CameronMccutcheon02/ECE477/Personals/Joey/newCalibrationPics/WIN_20231114_16_17_02_Pro.jpg

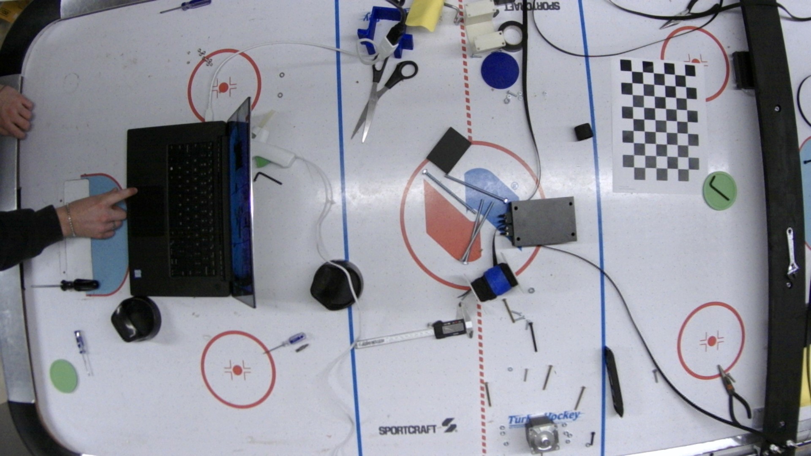
Personals/Joey/newCalibrationPics/WIN_20231114_16_17_02_Pro.jpg
