CameronMccutcheon02/ECE477/README.md

# ECE477
Final Project Repository for ECE477 building an air hockey robot. 
Link to website repo: https://github.com/CameronMccutcheon02/ECE477Website
