CameronMccutcheon02/ECE477/Hardware/README.md

# ECE477
Hardware section of the ECE477 repository. This directory to contain all of the system diagrams, PCB files, etc relating to hardware of the robot
