CameronMccutcheon02/ECE477/Software/README.md

# ECE477
This folder to contain all software (both micro and powerPC) software written for the air hockey bot
