CameronMccutcheon02/ECE477/Hardware/Notes.txt

Parts Needed
STM32f091RCT6
JTAG 10 pin flat ribbon connector
