CameronMccutcheon02/ECE477/Personals/Abby/Notes.txt

-------------- WEEK 14 PROGRESS ------------- 
Notes:
- troubleshooting motors
    - it looks like the Nema23 can handle 3A? look into upping the current by driver switch settings
    - Nema23 seem to often be powered off of 48V 
    - test with different steps/rev settings ?

- hours
    - fri: 2 (starting integration)
    - sat: 8 w joey this sucked (troubleshooting camera w motors / motor problem)
    - sun: 2 (worked on keys code + troubleshooting + research into motors)
    - mon

To-do:
- troubleshoo
