CameronMccutcheon02/ECE477/Hardware/477 Electrical Overview.drawio.png

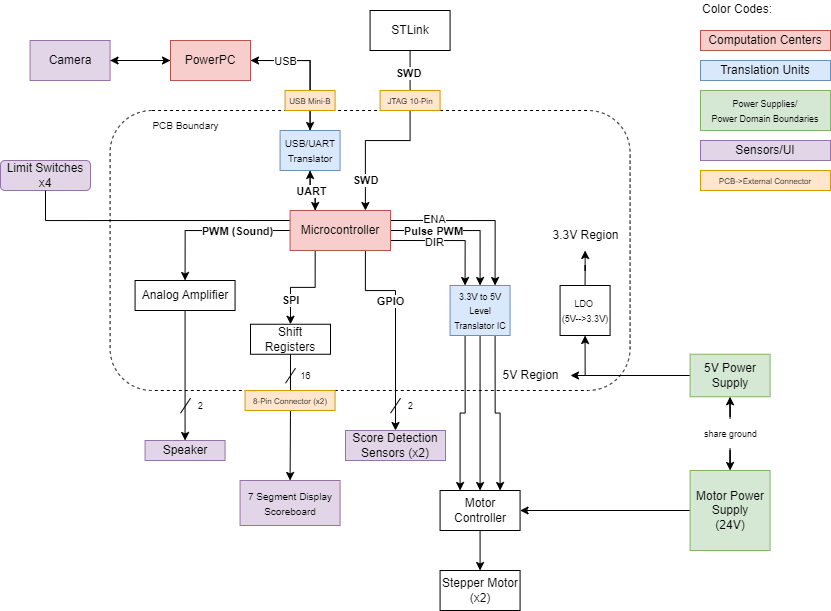
Hardware/477 Electrical Overview.drawio.png
