CameronMccutcheon02/ECE477/Personals/Joey/falseMallet.jpg

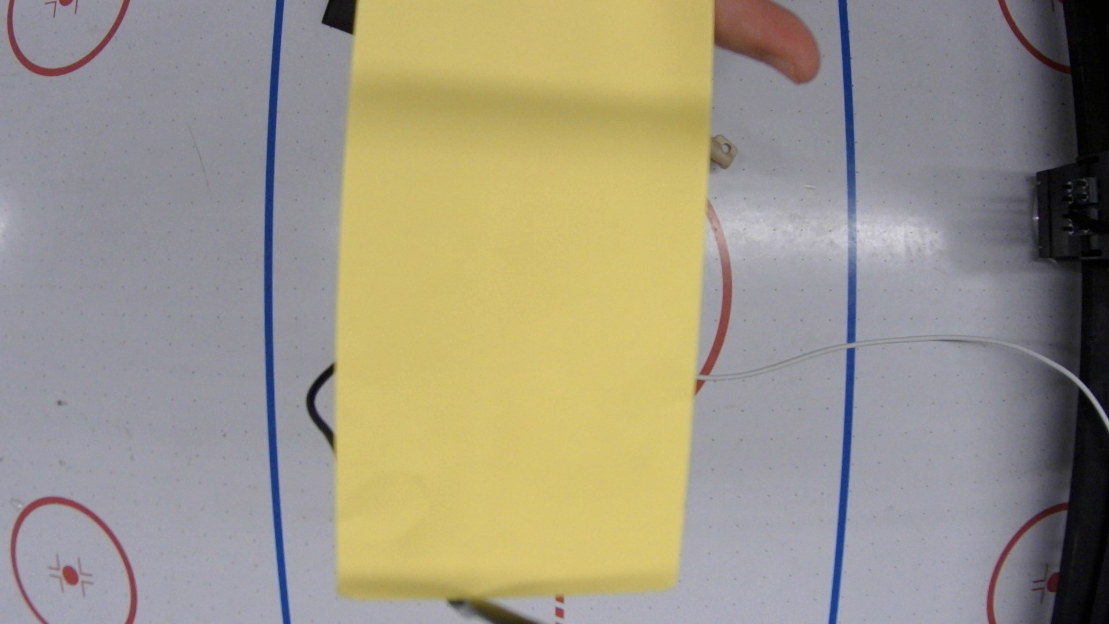
Personals/Joey/falseMallet.jpg
