CameronMccutcheon02/ECE477/Personals/Joey/goldmalletPic.jpg

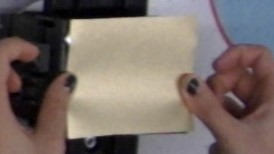
Personals/Joey/goldmalletPic.jpg
