CameronMccutcheon02/ECE477/Personals/Joey/malletPic.jpg

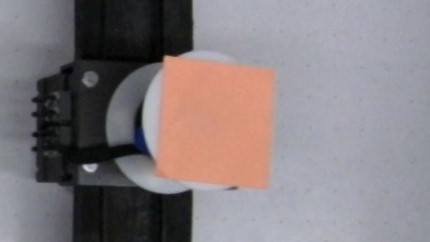
Personals/Joey/malletPic.jpg
