CameronMccutcheon02/ECE477/Personals/Joey/pinkmalletPic.jpg

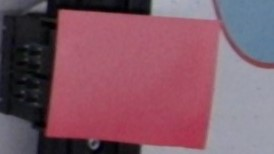
Personals/Joey/pinkmalletPic.jpg
