CameronMccutcheon02/ECE477/Personals/Joey/puckPic.jpg

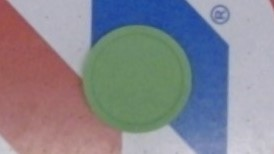
Personals/Joey/puckPic.jpg
