CameronMccutcheon02/ECE477/Personals/Joey/purplemalletPic.jpg

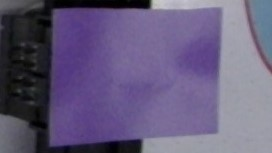
Personals/Joey/purplemalletPic.jpg
