CameronMccutcheon02/ECE477/Personals/Joey/yellowmalletPic.jpg

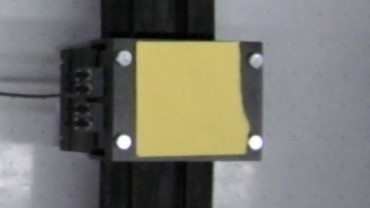
Personals/Joey/yellowmalletPic.jpg
