CameronMccutcheon02/ECE477/Mechanics/Senior Design Purchase Request (Amazon).xlsx

College of Engineering Senior Design Purchase Request Form |  |  | Department Name: | Today's Date: | 2023-09-29
 |  |  | ECE | Need-By Date: | ASAP
Vendor: | Amazon |  | Team Name / Project: | Your Name: | Abby Haluska
Website: | Amazon.com |  | 16 / Air Hockey Robot | Building.: | BHEE
Phone Number: |  |  |  | Room Number: | 7
Vendor Contact: |  |  | Account Number: | Phone Number: | 219-801-8580
Contact Email: |  |  | 7600000796 | Email Address: | ahaluska@purdue.edu
ITEM NAME / PART NUMBER |  | DESCRIPTION & LINK |  |  | QUANTITY | UNIT COST | TOTAL COST
VEVOR Linear Rail, 2 PCS SBR16-1000 / B0BLSD9WY3 |  | VEVOR Linear Rail / https://www.amazon.com/VEVOR-SBR12-1000mm-Carriage-Automated-Equipments/dp/B0BLSD9WY3 |  |  | 1.00 | $45.99 | $45.99
GT2 Open Timing Belt for 3D Printer 5M, 10MM width / B08SQ32RSR |  | Open Timing Belt / https://www.amazon.com/Timing-Printer-Meters-Fiberglass-Reinforced/dp/B08SQ32RSR |  |  | 1.00 | $16.89 | $16.89
 |  |  |  |  |  |  | $0.00
 |  |  |  |  |  |  | $0.00
 |  |  |  |  |  |  | $0.00
 |  |  |  |  |  | $0.00 | $0.00
 |  |  |  |  |  | $0.00 | $0.00
 |  |  |  |  |  | $0.00 | $0.00
 |  |  |  |  |  | $0.00 | $0.00
 |  |  |  |  |  | $0.00 | $0.00
 |  |  |  |  |  | $0.00 | $0.00
 |  |  |  |  |  | $0.00 | $0.00
 |  |  |  |  |  | $0.00 | $0.00
 |  |  |  |  |  | $0.00 | $0.00
 |  |  |  |  |  | $0.00 | $0.00
 |  |  |  |  |  | $0.00 | $0.00
 |  |  |  |  |  | $0.00 | $0.00
 |  |  |  |  |  | $0.00 | $0.00
 |  |  |  |  |  | $0.00 | $0.00
 |  |  |  |  |  | $0.00 | $0.00
 |  |  |  |  |  | $0.00 | $0.00
Shipping / Handling |  |  |  |  |  | $0.00 | $0.00
Requisition Total |  |  |  |  |  |  | $62.88
*** ALL BLUE CELLS are Mandatory *** Do Not Alter Formulas ***
