CameronMccutcheon02/ECE477/Mechanics/Senior Design Purchase Request (Adafruit).xlsx

College of Engineering Senior Design Purchase Request Form |  |  | Department Name: | Today's Date: | 2023-09-21
 |  |  | ECE | Need-By Date: | ASAP
Vendor: | Adafruit |  | Team Name / Project: | Your Name: | Abby Haluska
Website: | www.adafruit.com |  | 16 / Air Hockey Robot | Building: | EE
Phone Number: | 646-248-7822 |  |  | Room Number: | 7
Vendor Contact: | - |  | Account Number: | Phone Number: | 219-801-8580
Contact Email: | support@adafruit.com |  | 7600000796 | Email Address: | ahaluska@purdue.edu
ITEM NAME / PART NUMBER |  | DESCRIPTION & LINK |  |  | QUANTITY | UNIT COST | TOTAL COST
IR Break Beam Sensor with Premium Wire Header Ends - 5mm LEDs / 2168 |  | Infrared (IR) break-beam sensors / https://www.adafruit.com/product/2168 |  |  | 2.00 | $5.95 | $11.90
 |  |  |  |  |  | $0.00 | $0.00
 |  |  |  |  |  | $0.00 | $0.00
 |  |  |  |  |  | $0.00 | $0.00
 |  |  |  |  |  | $0.00 | $0.00
 |  |  |  |  |  | $0.00 | $0.00
 |  |  |  |  |  | $0.00 | $0.00
 |  |  |  |  |  | $0.00 | $0.00
 |  |  |  |  |  | $0.00 | $0.00
 |  |  |  |  |  | $0.00 | $0.00
 |  |  |  |  |  | $0.00 | $0.00
 |  |  |  |  |  | $0.00 | $0.00
 |  |  |  |  |  | $0.00 | $0.00
 |  |  |  |  |  | $0.00 | $0.00
 |  |  |  |  |  | $0.00 | $0.00
 |  |  |  |  |  | $0.00 | $0.00
 |  |  |  |  |  | $0.00 | $0.00
 |  |  |  |  |  | $0.00 | $0.00
 |  |  |  |  |  | $0.00 | $0.00
 |  |  |  |  |  | $0.00 | $0.00
 |  |  |  |  |  | $0.00 | $0.00
Shipping / Handling |  |  |  |  |  | $0.00 | $0.00
Requisition Total |  |  |  |  |  |  | $11.90
*** ALL BLUE CELLS are Mandatory *** Do Not Alter Formulas ***
