CameronMccutcheon02/ECE477/Mechanics/Senior Design Purchase Request (Mouser).xlsx

College of Engineering Senior Design Purchase Request Form |  |  | Department Name: | Today's Date:
 |  |  | ECE | Need-By Date:
Vendor: | Mouser |  | Team Name / Project: | Your Name: | Abby Haluska
Website: | www.mouser.com |  | 16 / Air Hockey Robot | Building: | EE
Phone Number: | 1-800-346-6873 |  |  | Room Number: | 7
Vendor Contact: | - |  | Account Number: | Phone Number: | 219-801-8580
Contact Email: | sales@mouser.com |  | 7600000796 | Email Address: | ahaluska@purdue.edu
ITEM NAME / PART NUMBER |  | DESCRIPTION & LINK |  |  | QUANTITY | UNIT COST | TOTAL COST
STM32F091RCT6 / 511 |  | ARM Microcontrollers - MCU Mainstream Arm Cortex-M0 / https://www.mouser.com/ProductDetail/STMicroelectronics/STM32F091RCT6?qs=ClYTdQWm4hDCc82GnPpqOQ%3D%3D |  |  | 3.00 | $5.36 | $16.08
 |  |  |  |  |  | $0.00 | $0.00
 |  |  |  |  |  | $0.00 | $0.00
 |  |  |  |  |  | $0.00 | $0.00
 |  |  |  |  |  | $0.00 | $0.00
 |  |  |  |  |  | $0.00 | $0.00
 |  |  |  |  |  | $0.00 | $0.00
 |  |  |  |  |  | $0.00 | $0.00
 |  |  |  |  |  | $0.00 | $0.00
 |  |  |  |  |  | $0.00 | $0.00
 |  |  |  |  |  | $0.00 | $0.00
 |  |  |  |  |  | $0.00 | $0.00
 |  |  |  |  |  | $0.00 | $0.00
 |  |  |  |  |  | $0.00 | $0.00
 |  |  |  |  |  | $0.00 | $0.00
 |  |  |  |  |  | $0.00 | $0.00
 |  |  |  |  |  | $0.00 | $0.00
 |  |  |  |  |  | $0.00 | $0.00
 |  |  |  |  |  | $0.00 | $0.00
 |  |  |  |  |  | $0.00 | $0.00
 |  |  |  |  |  | $0.00 | $0.00
Shipping / Handling |  |  |  |  |  | $0.00 | $0.00
Requisition Total |  |  |  |  |  |  | $16.08
*** ALL BLUE CELLS are Mandatory *** Do Not Alter Formulas ***
