CameronMccutcheon02/ECE477/Hardware/PCB/Useful Documentation/stm32f091-ref/stm32f091-ref/models/HTSW-130-22-T-S.FCStd

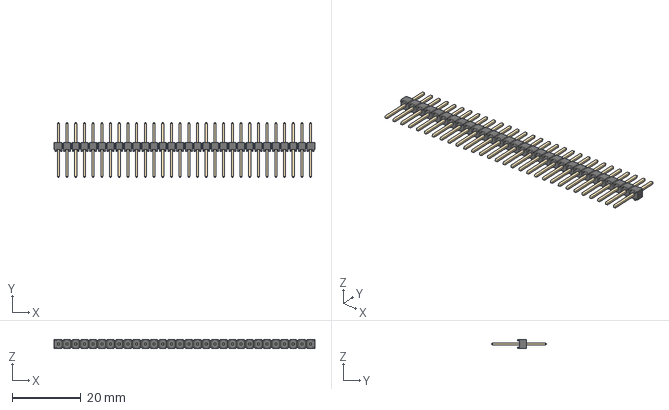
[picture p11: CAD file, 2023-09-29]
Hardware/PCB/Useful Documentation/stm32f091-ref/stm32f091-ref/models/HTSW-130-22-T-S.FCStd
76.2 x 16.0 x 2.49 mm
_HTSW-130-22-T-S_body
_T-1S6-15-HTSW-1--22-30-S
