CameronMccutcheon02/ECE477/Personals/Abby/cad/24v mount v2.stl

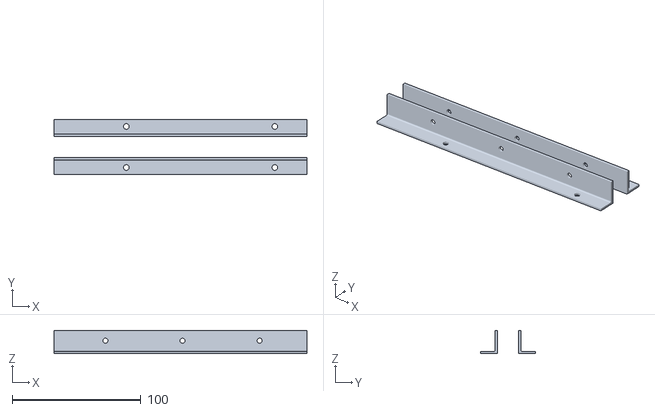
[picture p12: CAD file, 2023-11-19]
Personals/Abby/cad/24v mount v2.stl
196.9 x 42.9 x 18.0
