CameronMccutcheon02/ECE477/Hardware/PCB/Useful Documentation/stm32f091-ref/stm32f091-ref/models/ECX-.327-CDX-1293.step

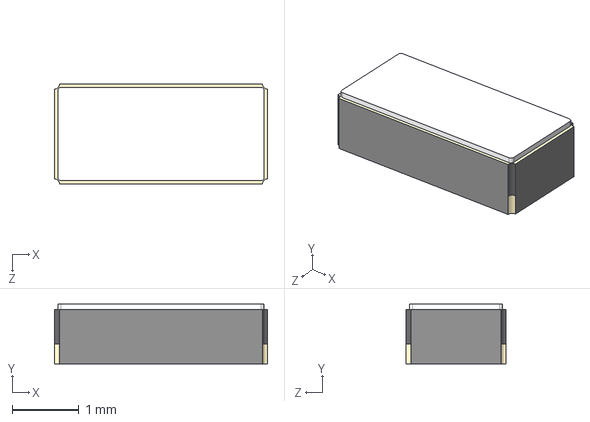
[picture p13: CAD file, 2023-09-29]
Hardware/PCB/Useful Documentation/stm32f091-ref/stm32f091-ref/models/ECX-.327-CDX-1293.step
3.20 x 0.9 x 1.50 mm
