CameronMccutcheon02/ECE477/Personals/Abby/cad/puck v1.stl

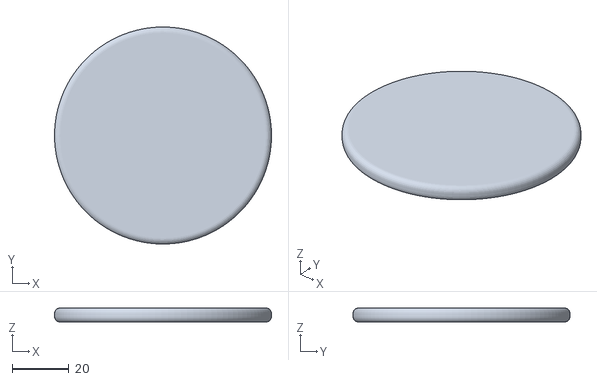
[picture p14: CAD file, 2023-10-17]
Personals/Abby/cad/puck v1.stl
76.2 x 76.2 x 5.00
