CameronMccutcheon02/ECE477/Personals/Abby/cad/cam v1 v0.stl

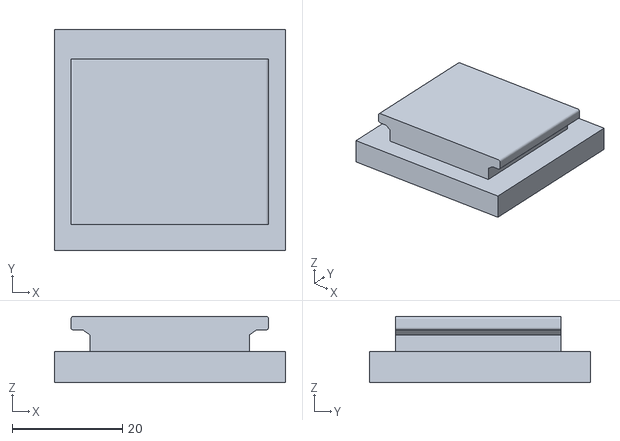
[picture p15: CAD file, 2023-10-17]
Personals/Abby/cad/cam v1 v0.stl
41.9 x 40.1 x 12.1
