CameronMccutcheon02/ECE477/Personals/Abby/cad/puck fun funnel.stl

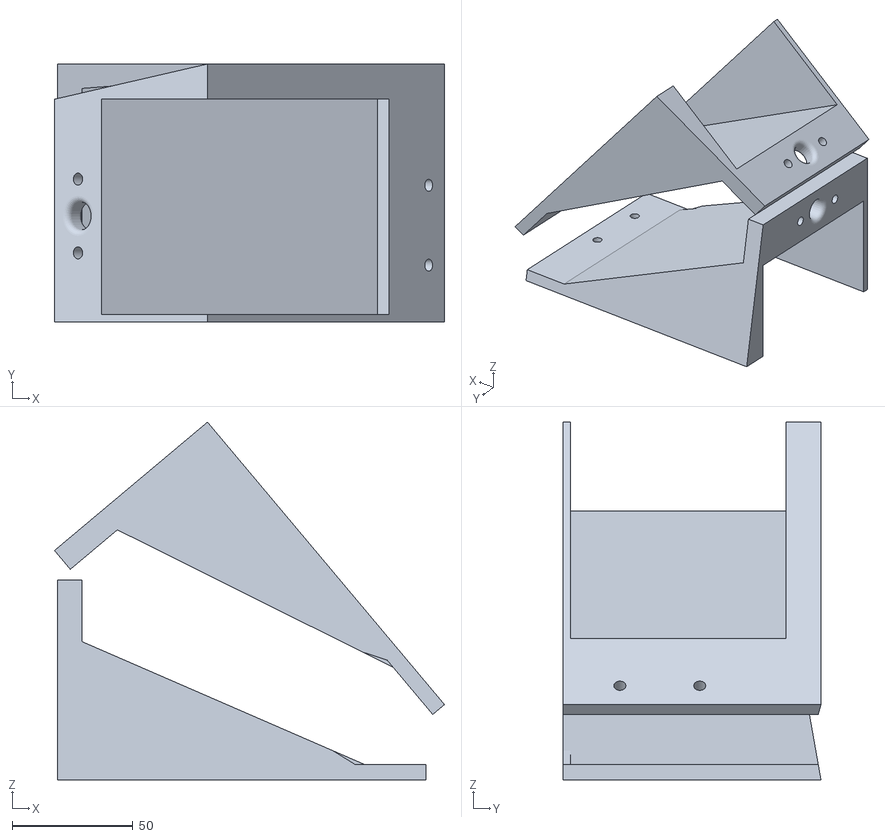
[picture p17: CAD file, 2023-09-20]
Personals/Abby/cad/puck fun funnel.stl
161.2 x 106.6 x 147.9
