CameronMccutcheon02/ECE477/Personals/Abby/cad/table extension v2.stl

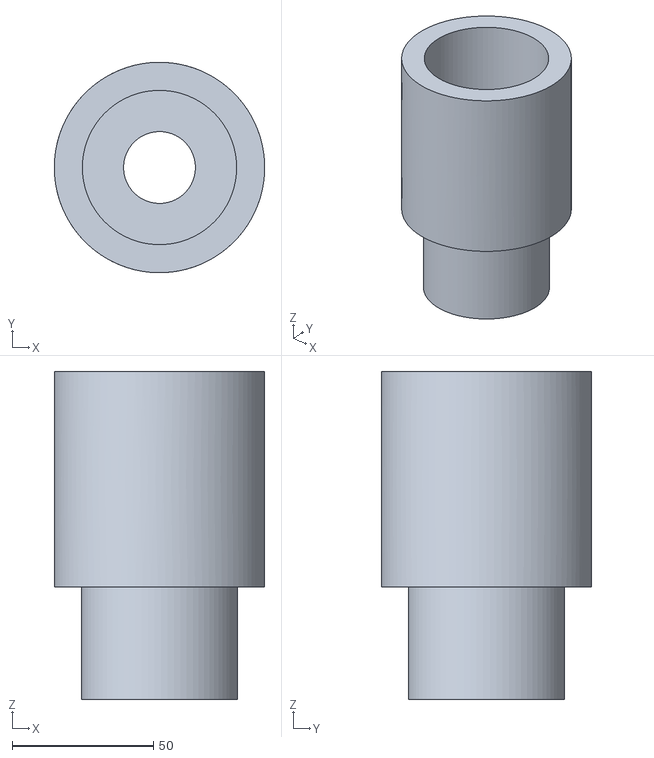
[picture p18: CAD file, 2023-09-20]
Personals/Abby/cad/table extension v2.stl
74.4 x 74.4 x 115.9
