CameronMccutcheon02/ECE477/Personals/Abby/cad/Part Studio 1 - Metal Bracket.stl

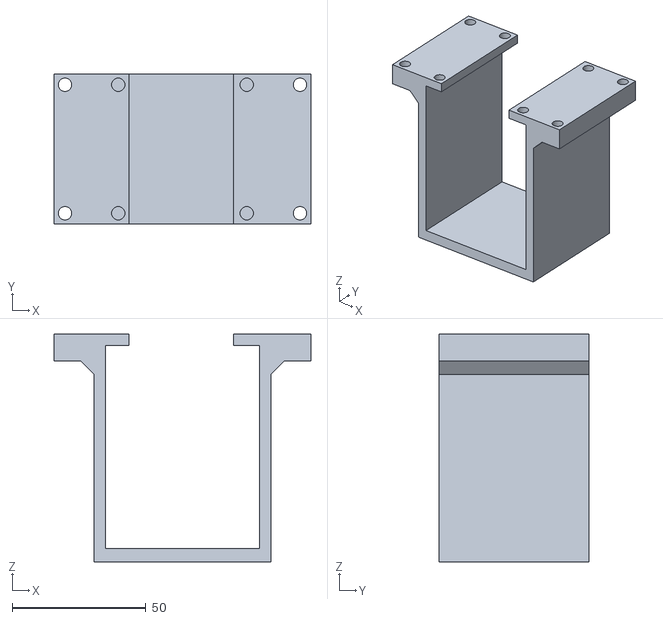
[picture p19: CAD file, 2023-09-20]
Personals/Abby/cad/Part Studio 1 - Metal Bracket.stl
96.0 x 56.0 x 85.0
