CameronMccutcheon02/ECE477/(list of files, cad)

Other CAD files:
Personals/Abby/cad/24v mount v1.f3d
Personals/Abby/cad/cam v1.f3d
