CameronMccutcheon02/ECE477/Personals/Joey/calibrationPics/WIN_20231109_14_38_01_Pro.jpg

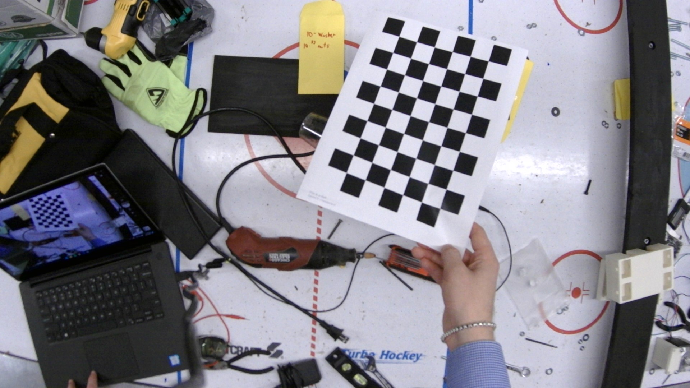
Personals/Joey/calibrationPics/WIN_20231109_14_38_01_Pro.jpg
