CameronMccutcheon02/ECE477/Hardware/PCB/Protoboard/Protoboard.kicad_pcb

## KiCad design Hardware/PCB/Protoboard/Protoboard.kicad_pcb (2023-11-06)

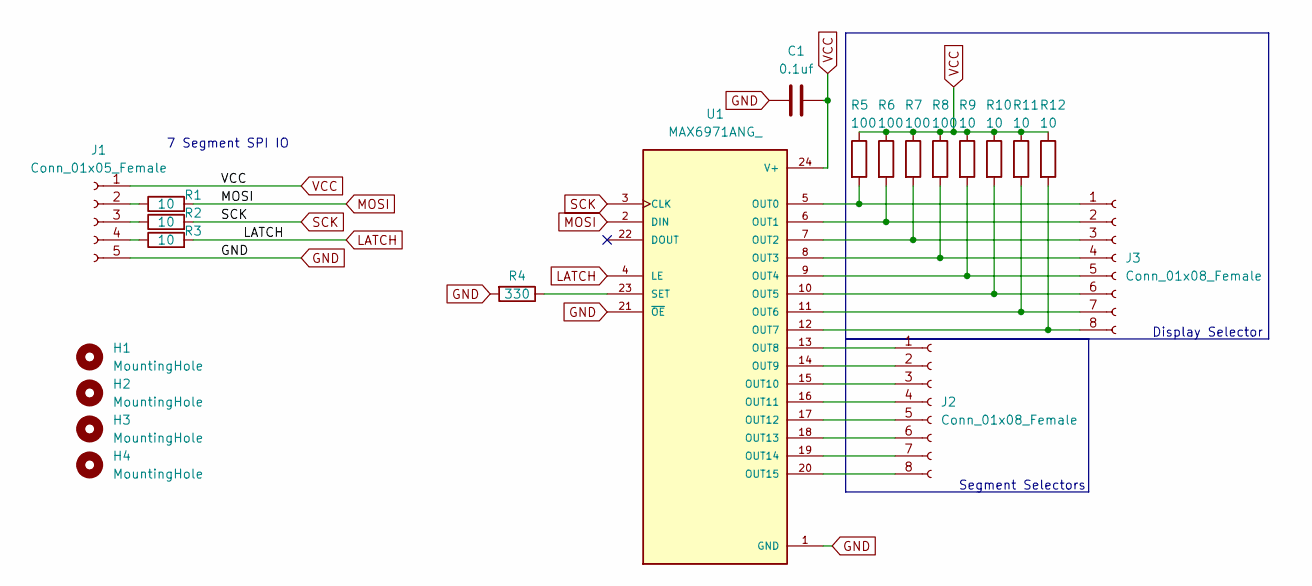
[picture p40: schematic Protoboard.kicad_sch]

Parts:
C1: 0.1uf; C_0805_2012Metric_Pad1.18x1.45mm_HandSolder
H1, H2, H3, H4: MountingHole; MountingHole_2.2mm_M2
J1: Conn_01x05_Female; PinSocket_1x05_P2.54mm_Vertical
J2, J3: Conn_01x08_Female; PinSocket_1x08_P2.54mm_Vertical
R1, R2, R3, R9, R10, R11, R12: 10; R_0805_2012Metric_Pad1.20x1.40mm_HandSolder
R4: 330; R_0805_2012Metric_Pad1.20x1.40mm_HandSolder
R5, R6, R7, R8: 100; R_0805_2012Metric_Pad1.20x1.40mm_HandSolder
U1: MAX6971ANG_; DIP794W47P254L3213H457Q24; PARTREV D

Connections:
GND: C1.1, J1.5, R4.2, U1.1 (GND), U1.21 (~OE)
LATCH: R3.2, U1.4 (LE)
MOSI: R1.2, U1.2 (DIN)
unnamed: J1.2, R1.1
unnamed: J1.3, R2.1
unnamed: J1.4, R3.1
unnamed: J2.1, U1.13 (OUT8)
unnamed: J2.2, U1.14 (OUT9)
unnamed: J2.3, U1.15 (OUT10)
unnamed: J2.4, U1.16 (OUT11)
unnamed: J2.5, U1.17 (OUT12)
unnamed: J2.6, U1.18 (OUT13)
unnamed: J2.7, U1.19 (OUT14)
unnamed: J2.8, U1.20 (OUT15)
unnamed: J3.1, R5.2, U1.5 (OUT0)
unnamed: J3.2, R6.2, U1.6 (OUT1)
unnamed: J3.3, R7.2, U1.7 (OUT2)
unnamed: J3.4, R8.2, U1.8 (OUT3)
unnamed: J3.5, R9.2, U1.9 (OUT4)
unnamed: J3.6, R10.2, U1.10 (OUT5)
unnamed: J3.7, R11.2, U1.11 (OUT6)
unnamed: J3.8, R12.2, U1.12 (OUT7)
unnamed: R4.1, U1.23 (SET)
SCK: R2.2, U1.3 (CLK)
VCC: C1.2, J1.1, R5.1, R6.1, R7.1, R8.1, R9.1, R10.1, R11.1, R12.1, U1.24 (V+)

Notes on the sheet:
Segment Selectors
7 Segment SPI IO
Display Selector

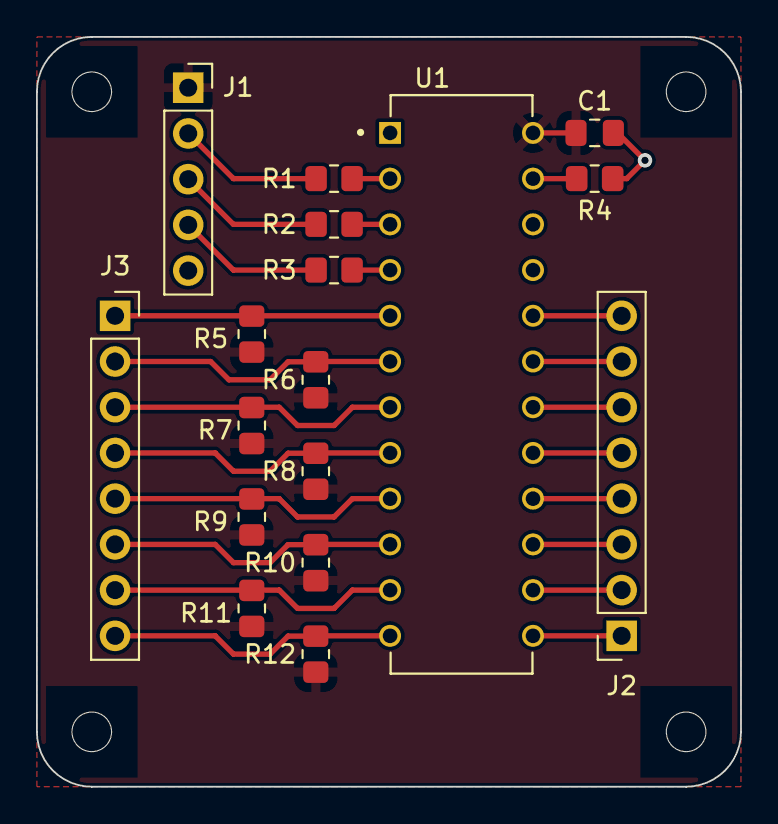
[picture p41: board Protoboard.kicad_pcb from above]

Board: 2 copper layers, 39.1 x 41.7 mm, 21 parts (0 on the bottom side), 25 nets.
