CameronMccutcheon02/ECE477/Hardware/PCB/Scoreboard/Scoreboard.kicad_pcb

## KiCad design Hardware/PCB/Scoreboard/Scoreboard.kicad_pcb (2023-11-03)

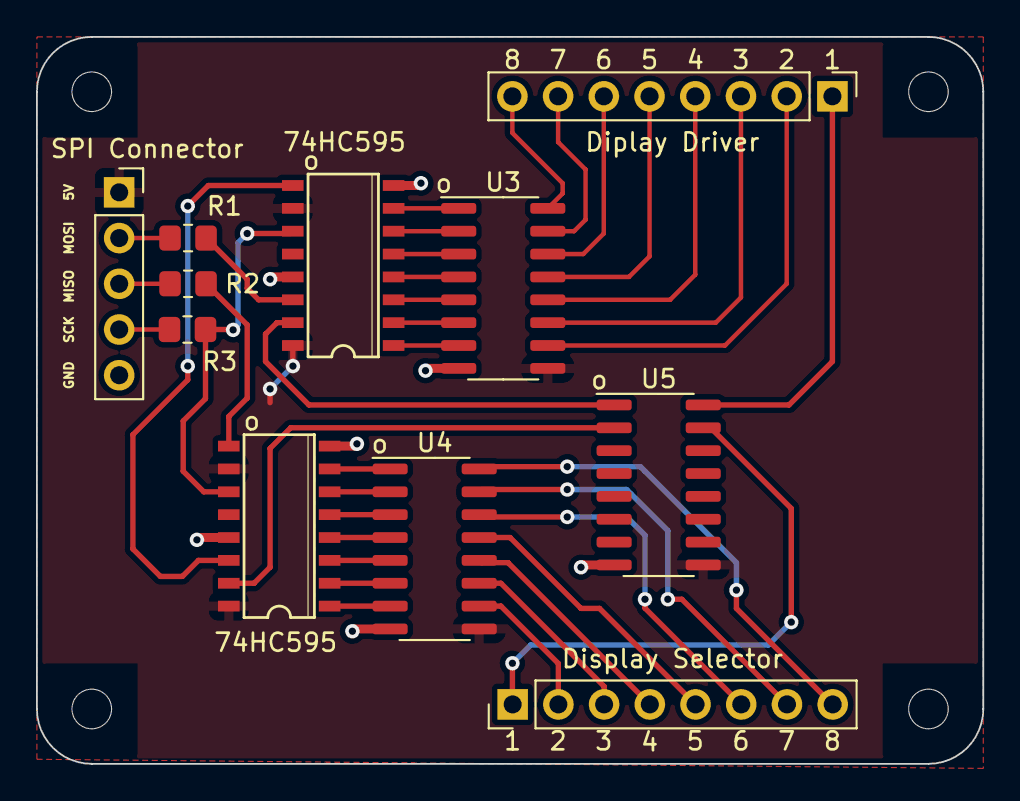
[picture p42: board Scoreboard.kicad_pcb from above]

Board: 2 copper layers, 52.6 x 40.4 mm, 15 parts (0 on the bottom side), 41 nets.

Parts:
74HC595, 74HC595#2: 74HC595; SO16
Display Selector: Conn_01x08_Male; PinHeader_1x08_P2.54mm_Vertical
H1, H2, H3, H4: MountingHole; MountingHole_2.2mm_M2
J2: Conn_01x08_Male; PinHeader_1x08_P2.54mm_Vertical
R1, R2, R3: 10; R_0805_2012Metric_Pad1.20x1.40mm_HandSolder
SPI Connector: Conn_01x05_Female; PinSocket_1x05_P2.54mm_Vertical
U3, U4, U5: MC1413D; SOIC-16_3.9x9.9mm_P1.27mm

Connections:
/QA1: 74HC595.15 (QA), U5.1 (I1)
/QA2: 74HC595#2.15 (QA), U5.2 (I2)
/QB1: 74HC595.1 (QB), U3.7 (I7)
/QB2: 74HC595#2.1 (QB), U4.7 (I7)
/QC1: 74HC595.2 (QC), U3.6 (I6)
/QC2: 74HC595#2.2 (QC), U4.6 (I6)
/QD1: 74HC595.3 (QD), U3.5 (I5)
/QD2: 74HC595#2.3 (QD), U4.5 (I5)
/QE1: 74HC595.4 (QE), U3.4 (I4)
/QE2: 74HC595#2.4 (QE), U4.4 (I4)
/QF1: 74HC595.5 (QF), U3.3 (I3)
/QF2: 74HC595#2.5 (QF), U4.3 (I3)
/QG1: 74HC595.6 (QG), U3.2 (I2)
/QG2: 74HC595#2.6 (QG), U4.2 (I2)
/QH1: 74HC595.7 (QH), U3.1 (I1)
/QH2: 74HC595#2.7 (QH), U4.1 (I1)
/SPI1_MISO: 74HC595#2.9 (QH'), R2.2
/SPI1_MOSI: 74HC595.14 (SER), R1.2
/SPI1_SCK: 74HC595.11 (SRCLK), 74HC595#2.11 (SRCLK), R3.2
GND: 74HC595.8 (GND), 74HC595.13 (~OE), 74HC595#2.8 (GND), 74HC595#2.13 (~OE), SPI Connector.5, U3.8 (GND), U4.8 (GND), U5.8 (GND)
unnamed: R1.1, SPI Connector.2
unnamed: R2.1, SPI Connector.3
unnamed: R3.1, SPI Connector.4
unnamed: 74HC595.9 (QH'), 74HC595#2.14 (SER)
unnamed: J2.2, U3.10 (O7)
unnamed: J2.3, U3.11 (O6)
unnamed: J2.4, U3.12 (O5)
unnamed: J2.5, U3.13 (O4)
unnamed: J2.6, U3.14 (O3)
unnamed: J2.7, U3.15 (O2)
unnamed: J2.8, U3.16 (O1)
unnamed: Display Selector.2, U4.10 (O7)
unnamed: Display Selector.3, U4.11 (O6)
unnamed: Display Selector.4, U4.12 (O5)
unnamed: Display Selector.5, U4.13 (O4)
unnamed: Display Selector.6, U4.14 (O3)
unnamed: Display Selector.7, U4.15 (O2)
unnamed: Display Selector.8, U4.16 (O1)
unnamed: Display Selector.1, U5.15 (O2)
unnamed: J2.1, U5.16 (O1)
VCC: 74HC595.10 (~SRCLR), 74HC595.16 (VCC), 74HC595#2.10 (~SRCLR), 74HC595#2.16 (VCC), SPI Connector.1, U3.9 (COM), U4.9 (COM), U5.9 (COM)
