CameronMccutcheon02/ECE477/Hardware/PCB/MainMicro/MainMicro.kicad_pcb

## KiCad design Hardware/PCB/MainMicro/MainMicro.kicad_pcb (2023-10-26)

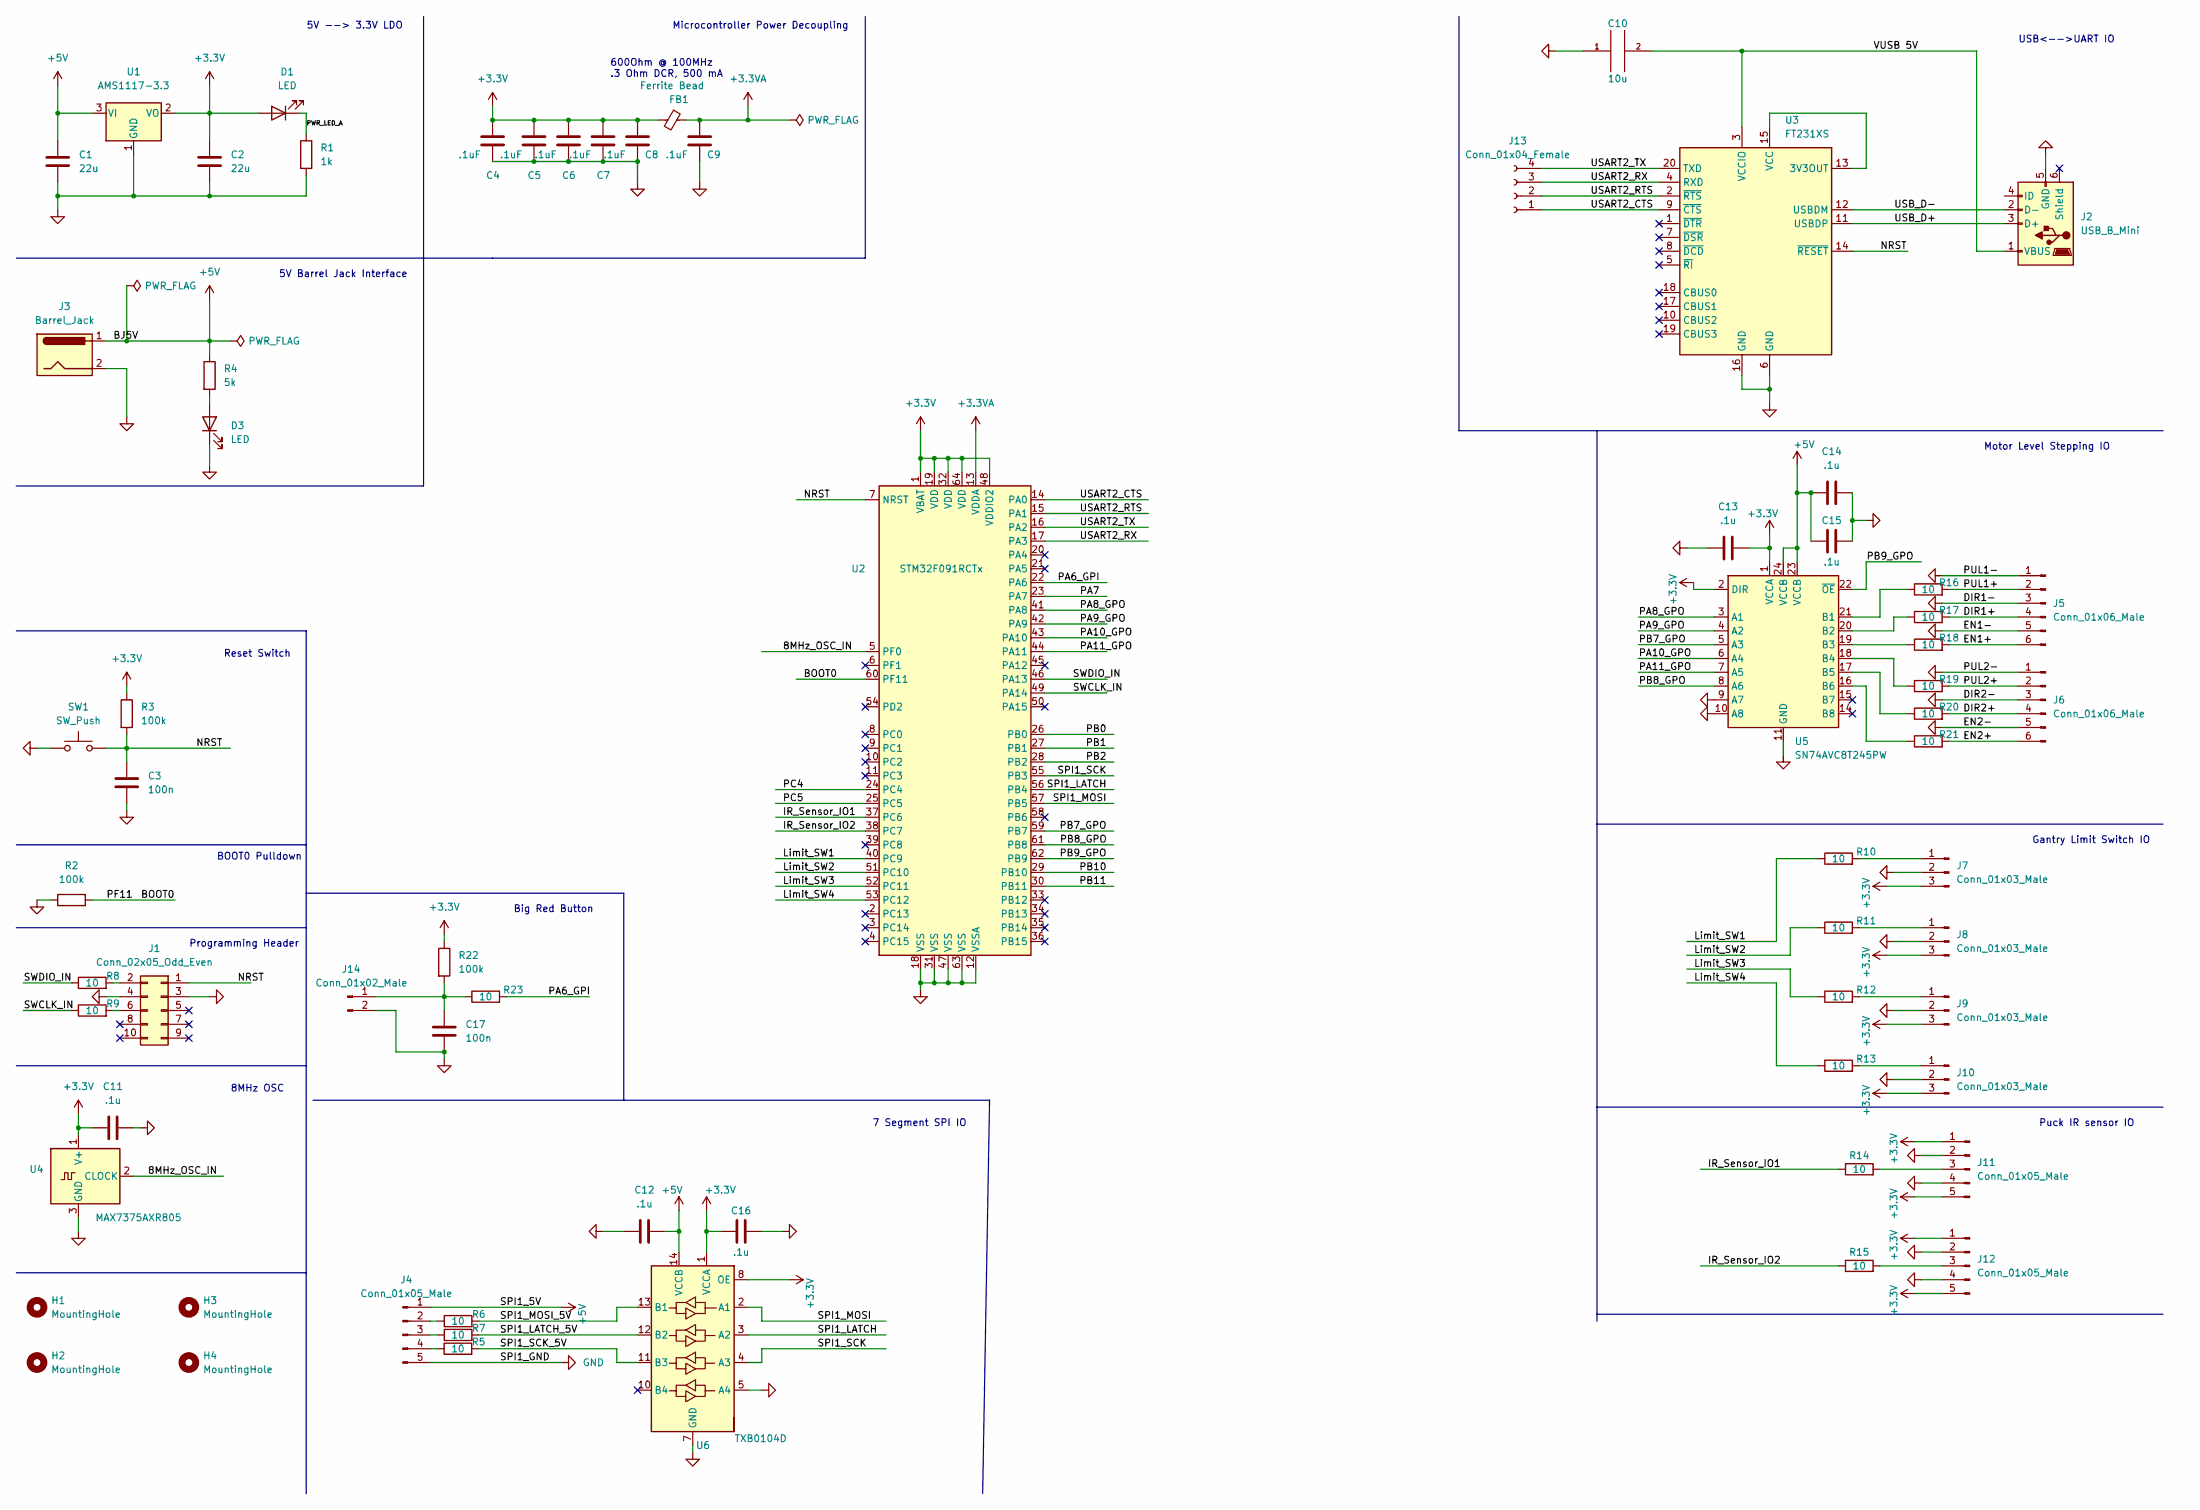
[picture p43: schematic MainMicro.kicad_sch]

Parts:
C1, C2: 22u; C_0805_2012Metric_Pad1.18x1.45mm_HandSolder
C3, C17: 100n; C_0805_2012Metric_Pad1.18x1.45mm_HandSolder
C4, C5, C6, C7, C8, C9: .1uF; C_0805_2012Metric_Pad1.18x1.45mm_HandSolder
C10: 10u; C_0805_2012Metric_Pad1.18x1.45mm_HandSolder
C11, C12, C13, C14, C15, C16: .1u; C_0805_2012Metric_Pad1.18x1.45mm_HandSolder
D1: LED; LED_0603_1608Metric_Pad1.05x0.95mm_HandSolder
D3: LED; LED_0805_2012Metric_Pad1.15x1.40mm_HandSolder
FB1: Ferrite Bead; L_0805_2012Metric_Pad1.15x1.40mm_HandSolder
H1, H2, H3, H4: MountingHole; MountingHole_2.7mm_M2.5
J1: Conn_02x05_Odd_Even; IDC-Header_2x05_P2.54mm_Latch_Vertical
J2: USB_B_Mini; USB_Micro-B_Amphenol_10118194_Horizontal
J3: Barrel_Jack; BarrelJack_CUI_PJ-102AH_Horizontal
J4, J11, J12: Conn_01x05_Male; JST_EH_B5B-EH-A_1x05_P2.50mm_Vertical
J5, J6: Conn_01x06_Male; JST_EH_B6B-EH-A_1x06_P2.50mm_Vertical
J7, J8, J9, J10: Conn_01x03_Male; JST_EH_B3B-EH-A_1x03_P2.50mm_Vertical
J13: Conn_01x04_Female; JST_EH_B4B-EH-A_1x04_P2.50mm_Vertical
J14: Conn_01x02_Male; JST_EH_B2B-EH-A_1x02_P2.50mm_Vertical
R1: 1k; R_0805_2012Metric_Pad1.20x1.40mm_HandSolder
R2, R3, R22: 100k; R_0805_2012Metric_Pad1.20x1.40mm_HandSolder
R4: 5k; R_0805_2012Metric_Pad1.20x1.40mm_HandSolder
R5, R6, R7, R8, R9, R10, R11, R12, R13, R14, R15, R16, R17, R18, R19, R20, R21, R23: 10; R_0805_2012Metric_Pad1.20x1.40mm_HandSolder
SW1: SW_Push; SW_SPST_PTS645
U1: AMS1117-3.3; SOT-223-3_TabPin2
U2: STM32F091RCTx; LQFP-64_10x10mm_P0.5mm
U3: FT231XS; SSOP-20_3.9x8.7mm_P0.635mm
U4: MAX7375AXR805; SOT-323_SC-70
U5: SN74AVC8T245PW; TSSOP-24_4.4x7.8mm_P0.65mm
U6: TXB0104D; SOIC-14_3.9x8.7mm_P1.27mm

Connections:
+3.3VA: C9.1, FB1.1, U2.13 (VDDA)
+3V3: C2.1, C4.1, C5.1, C6.1, C7.1, C8.1, C11.1, C13.1, C16.2, D1.2 (A), FB1.2, J7.3, J8.3, J9.3, J10.3, J11.1, J11.5, J12.1, J12.5, R3.1, R22.1, U1.2 (VO), U2.1 (VBAT), U2.19 (VDD), U2.32 (VDD), U2.48 (VDDIO2), U2.64 (VDD), U4.1 (V+), U5.1 (VCCA), U5.2 (DIR), U6.1 (VCCA), U6.8 (OE)
+5V: C1.1, C12.1, C14.2, C15.2, J3.1, J4.1, R4.1, U1.3 (VI), U5.23 (VCCB), U5.24 (VCCB), U6.14 (VCCB)
/8MHz_OSC_IN: U2.5 (PF0), U4.2 (CLOCK)
/BOOT0: R2.2, U2.60 (PF11)
/DIR1+: J5.4, R17.2
/DIR2+: J6.4, R20.2
/EN1+: J5.6, R18.2
/EN2+: J6.6, R21.2
/IR_Sensor_IO1: R14.1, U2.37 (PC6)
/IR_Sensor_IO2: R15.1, U2.38 (PC7)
/Limit_SW1: R10.1, U2.40 (PC9)
/Limit_SW2: R11.1, U2.51 (PC10)
/Limit_SW3: R12.1, U2.52 (PC11)
/Limit_SW4: R13.1, U2.53 (PC12)
/NRST: C3.1, J1.1, R3.2, SW1.2, U2.7 (NRST), U3.14 (~RESET)
/PA6_GPI: R23.2, U2.22 (PA6)
/PA7: U2.23 (PA7)
/PA8_GPO: U2.41 (PA8), U5.3 (A1)
/PA9_GPO: U2.42 (PA9), U5.4 (A2)
/PA10_GPO: U2.43 (PA10), U5.6 (A4)
/PA11_GPO: U2.44 (PA11), U5.7 (A5)
/PB0: U2.26 (PB0)
/PB1: U2.27 (PB1)
/PB2: U2.28 (PB2)
/PB7_GPO: U2.59 (PB7), U5.5 (A3)
/PB8_GPO: U2.61 (PB8), U5.8 (A6)
/PB9_GPO: U2.62 (PB9), U5.22 (~OE)
/PB10: U2.29 (PB10)
/PB11: U2.30 (PB11)
/PC4: U2.24 (PC4)
/PC5: U2.25 (PC5)
/PUL1+: J5.2, R16.2
/PUL2+: J6.2, R19.2
/PWR_LED_A: D1.1 (K), R1.1
/SPI1_LATCH: U2.56 (PB4), U6.3 (A2)
/SPI1_LATCH_5V: R7.2, U6.12 (B2)
/SPI1_MOSI: U2.57 (PB5), U6.2 (A1)
/SPI1_MOSI_5V: R6.2, U6.13 (B1)
/SPI1_SCK: U2.55 (PB3), U6.4 (A3)
/SPI1_SCK_5V: R5.2, U6.11 (B3)
/SWCLK_IN: R9.1, U2.49 (PA14)
/SWDIO_IN: R8.1, U2.46 (PA13)
/USART2_CTS: J13.1, U2.14 (PA0), U3.9 (~CTS)
/USART2_RTS: J13.2, U2.15 (PA1), U3.2 (~RTS)
/USART2_RX: J13.3, U2.17 (PA3), U3.4 (RXD)
/USART2_TX: J13.4, U2.16 (PA2), U3.20 (TXD)
/USB_D+: J2.3 (D+), U3.11 (USBDP)
/USB_D-: J2.2 (D-), U3.12 (USBDM)
/VUSB 5V: C10.2, J2.1 (VBUS), U3.3 (VCCIO)
GND: C1.2, C2.2, C3.2, C4.2, C5.2, C6.2, C7.2, C8.2, C9.2, C10.1, C11.2, C12.2, C13.2, C14.1, C15.1, C16.1, C17.2, D3.1 (K), J1.3, J1.4, J2.5 (GND), J3.2, J4.5, J5.1, J5.3, J5.5, J6.1, J6.3, J6.5, J7.2, J8.2, J9.2, J10.2, J11.2, J11.4, J12.2, J12.4, J14.2, R1.2, R2.1, SW1.1, U1.1 (GND), U2.12 (VSSA), U2.18 (VSS), U2.31 (VSS), U2.47 (VSS), U2.63 (VSS), U3.6 (GND), U3.16 (GND), U4.3 (GND), U5.9 (A7), U5.10 (A8), U5.11 (GND), U5.12 (GND), U5.13 (GND), U6.5 (A4), U6.7 (GND)
unnamed: C17.1, J14.1, R22.2, R23.1
unnamed: D3.2 (A), R4.2
unnamed: J1.2, R8.2
unnamed: J1.6, R9.2
unnamed: J4.2, R6.1
unnamed: J4.3, R7.1
unnamed: J4.4, R5.1
unnamed: J7.1, R10.2
unnamed: J8.1, R11.2
unnamed: J9.1, R12.2
unnamed: J10.1, R13.2
unnamed: J11.3, R14.2
unnamed: J12.3, R15.2
unnamed: R16.1, U5.21 (B1)
unnamed: R17.1, U5.20 (B2)
unnamed: R18.1, U5.19 (B3)
unnamed: R19.1, U5.18 (B4)
unnamed: R20.1, U5.17 (B5)
unnamed: R21.1, U5.16 (B6)
unnamed: U3.13 (3V3OUT), U3.15 (VCC)

Notes on the sheet:
USB<-->UART IO
Reset Switch
7 Segment SPI IO
8MHz OSC
Puck IR sensor IO
5V Barrel Jack Interface
Motor Level Stepping IO
BOOT0 Pulldown
5V --> 3.3V LDO
600Ohm @ 100MHz .3 Ohm DCR, 500 mA
Gantry Limit Switch IO
Microcontroller Power Decoupling
Programming Header
Big Red Button

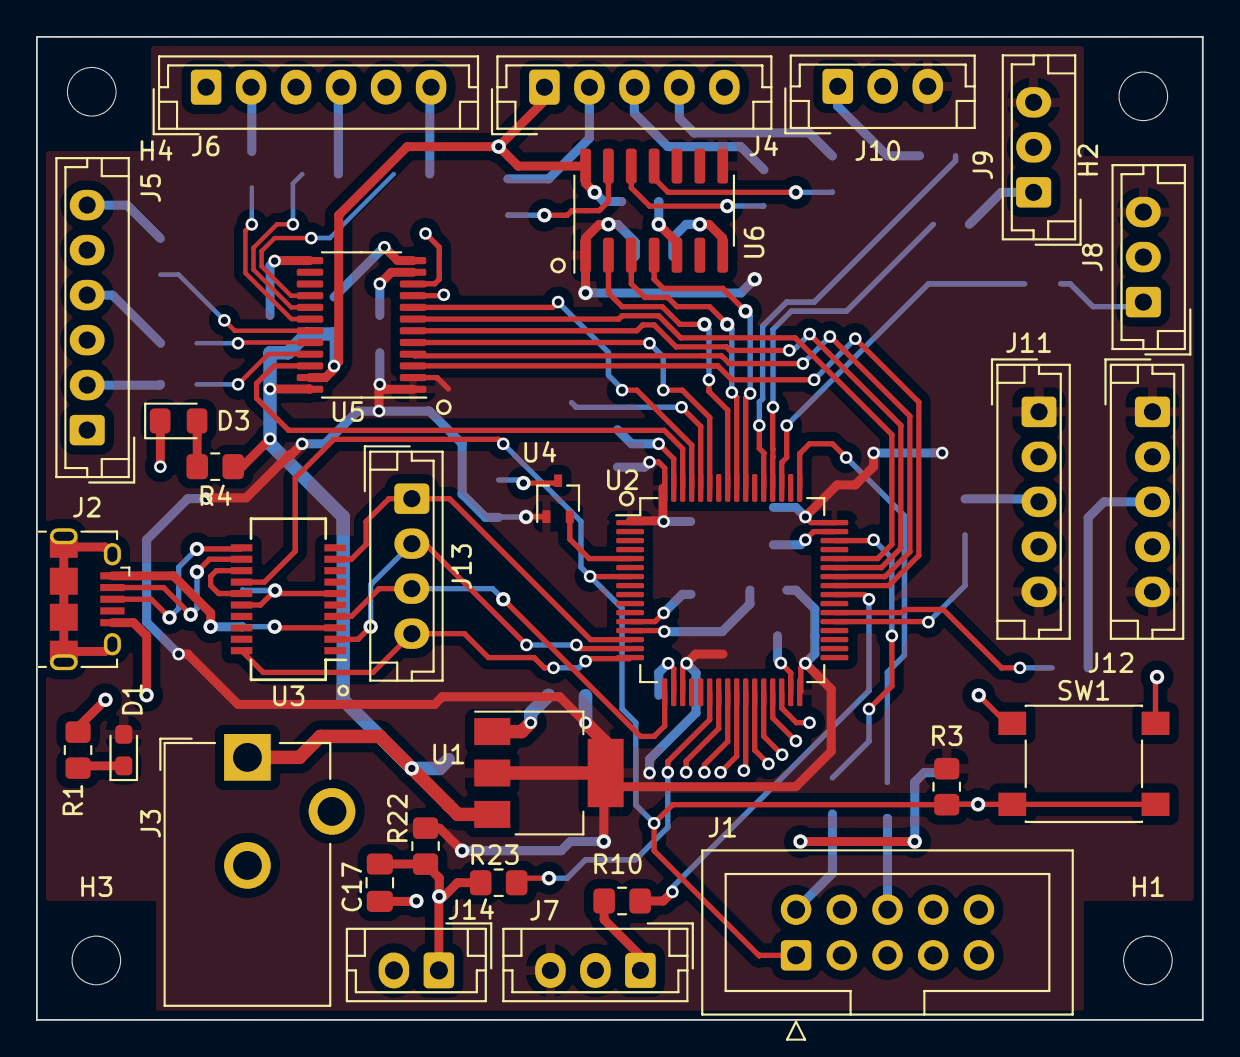
[picture p44: board MainMicro.kicad_pcb from above]

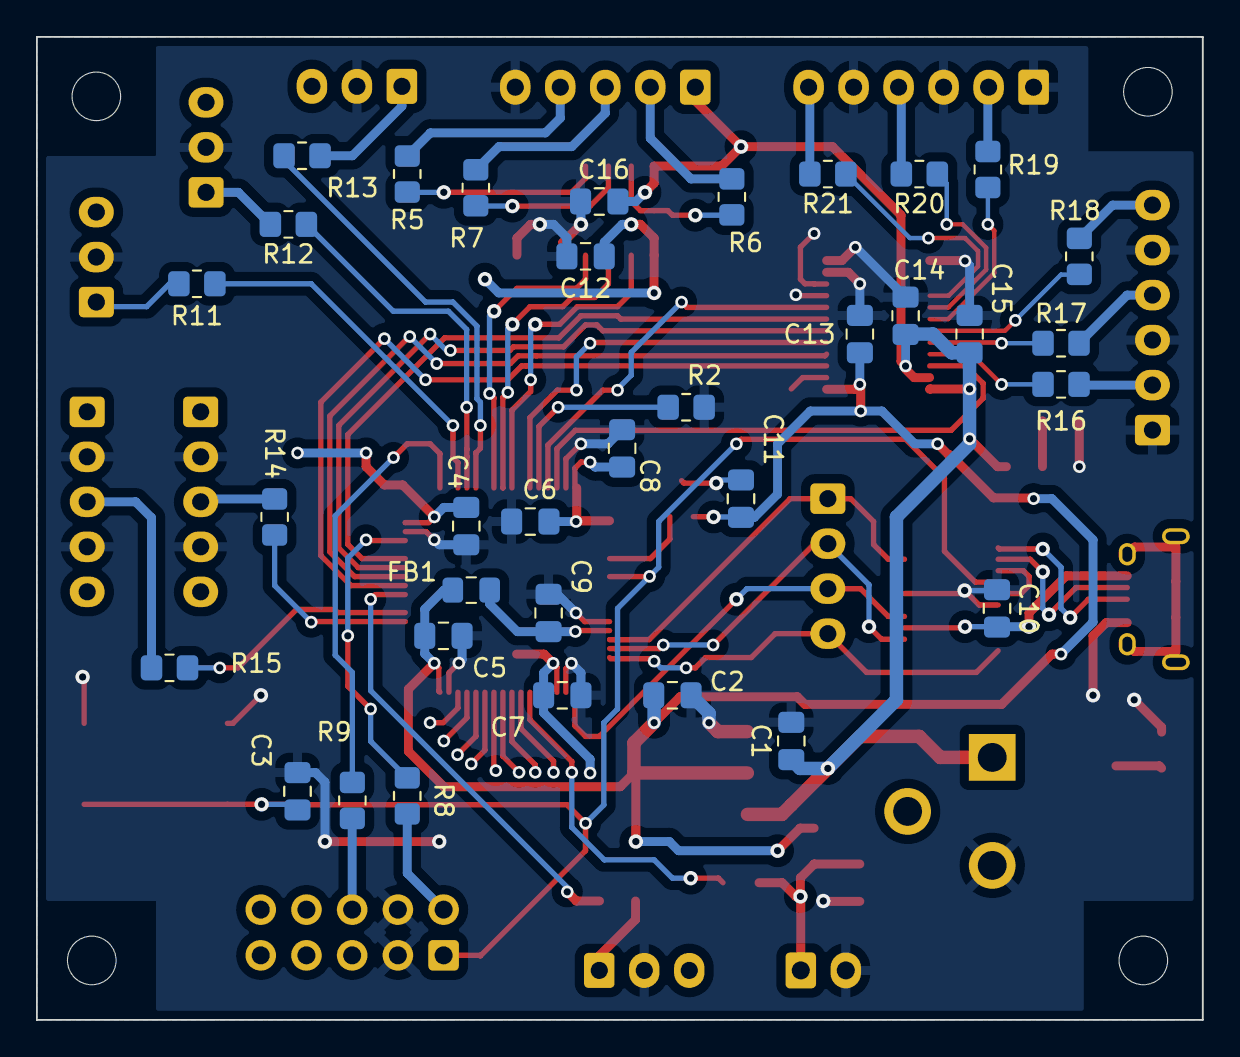
[picture p45: board MainMicro.kicad_pcb from below]

Board: 2 copper layers, 64.8 x 54.6 mm, 68 parts (34 on the bottom side), 63 nets.
