CameronMccutcheon02/ECE477/Hardware/PCB/Useful Documentation/stm32f091-ref/stm32f091-ref/stm32f091.kicad_pcb

## KiCad design Hardware/PCB/Useful Documentation/stm32f091-ref/stm32f091-ref/stm32f091.kicad_pcb (2023-09-29)

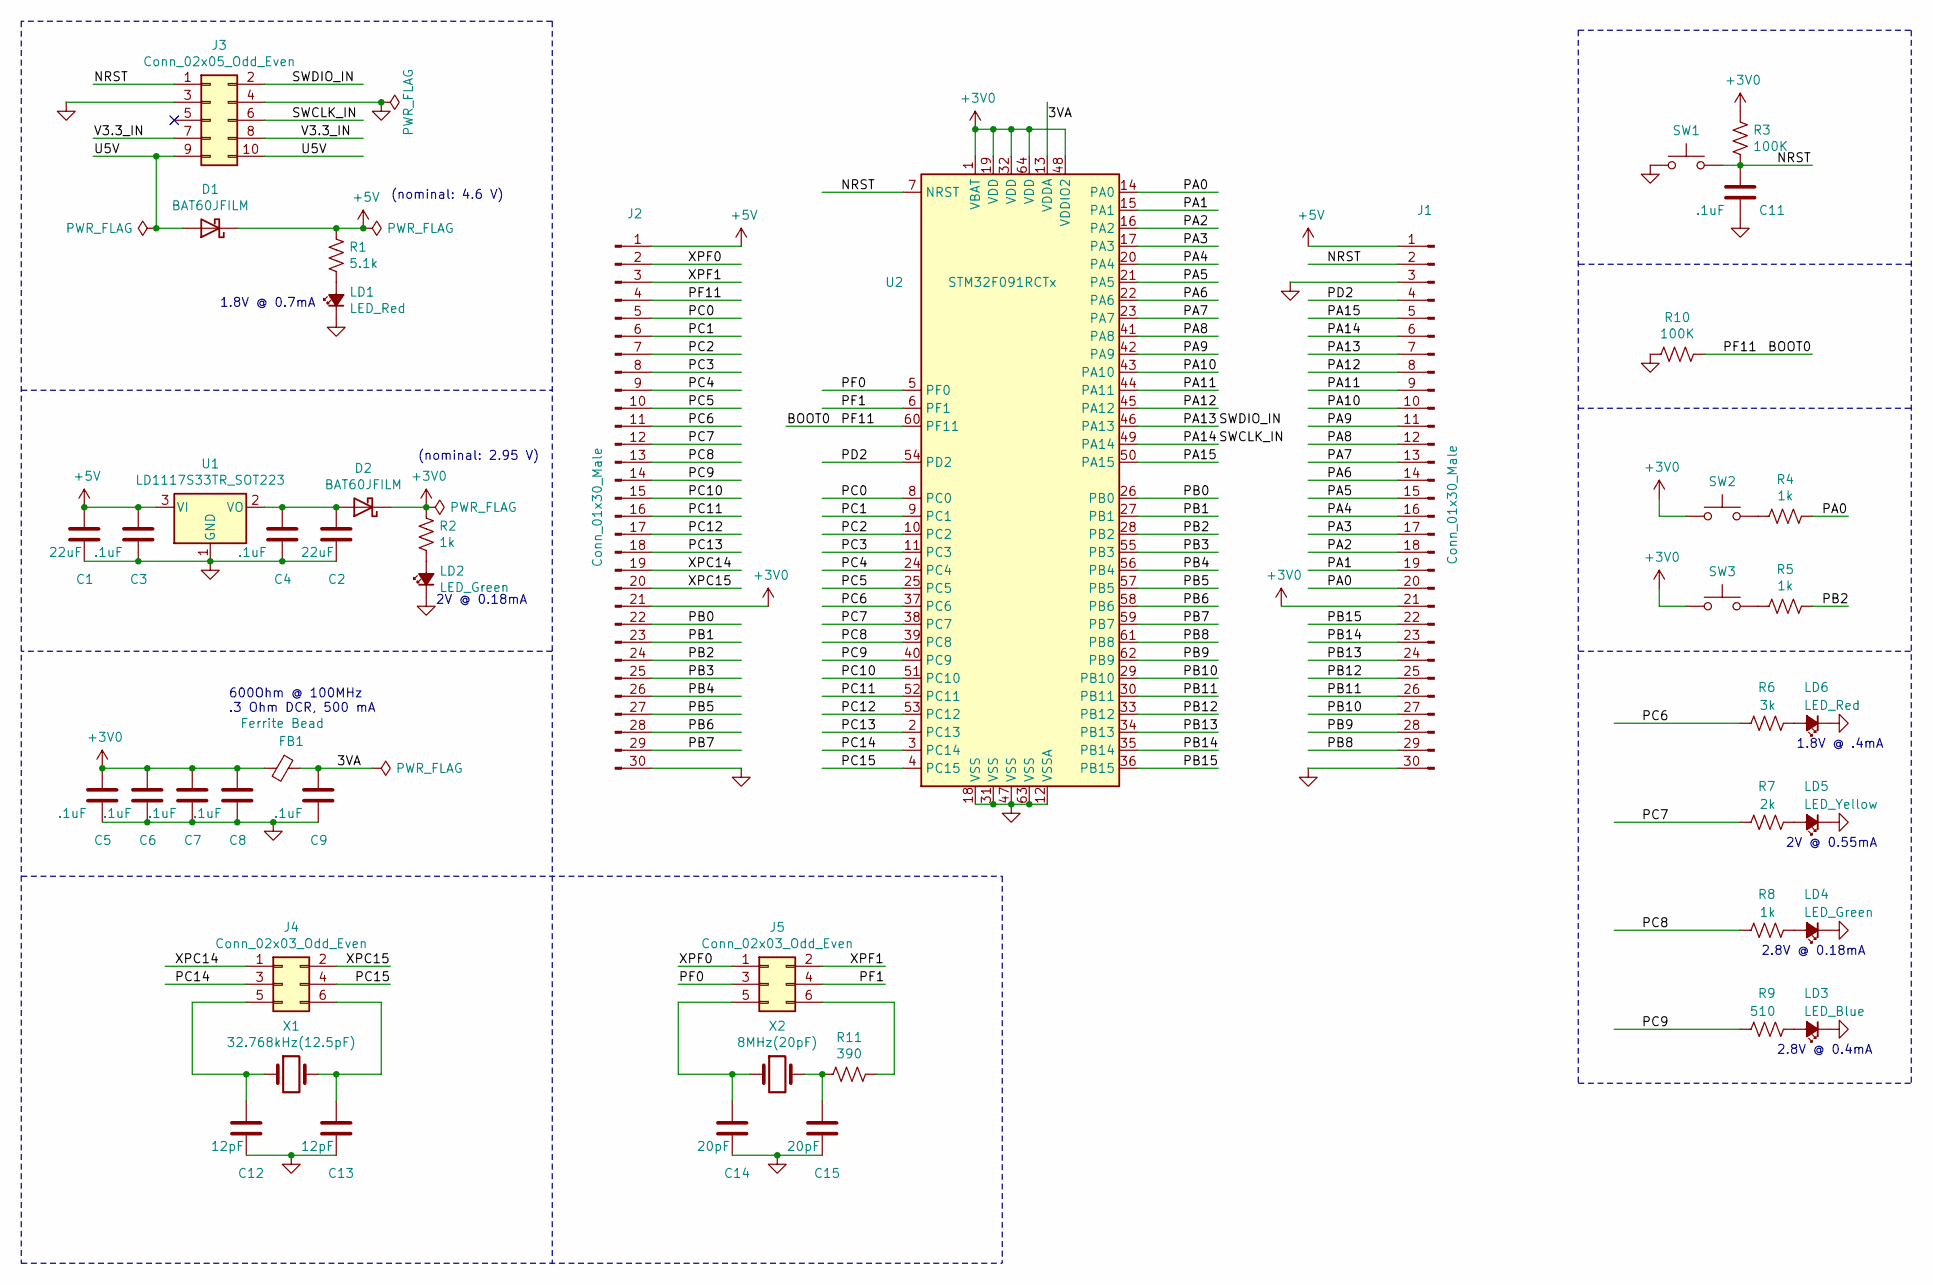
[picture p46: schematic stm32f091.sch, STM32F091 Dev Board]

Parts:
C1, C2: 22uF; C_0805_2012Metric_Pad1.15x1.40mm_HandSolder
C3, C4, C5, C6, C7, C8, C9, C11: .1uF; C_0805_2012Metric_Pad1.15x1.40mm_HandSolder
C12, C13: 12pF; C_0805_2012Metric_Pad1.15x1.40mm_HandSolder
C14, C15: 20pF; C_0805_2012Metric_Pad1.15x1.40mm_HandSolder
D1, D2: BAT60JFILM; D_SOD-323
FB1: Ferrite Bead; L_0805_2012Metric_Pad1.15x1.40mm_HandSolder
J1, J2: Conn_01x30_Male; HTSW-130-22-T-S
J3: Conn_02x05_Odd_Even; IDC-Header_2x05_P2.54mm_Vertical
J4, J5: Conn_02x03_Odd_Even; PinHeader_2x03_P1.27mm_Vertical
LD1, LD6: LED_Red; LED_0805_2012Metric
LD2, LD4: LED_Green; LED_0805_2012Metric
LD3: LED_Blue; LED_0805_2012Metric
LD5: LED_Yellow; LED_0805_2012Metric
R1: 5.1k; R_0805_2012Metric_Pad1.15x1.40mm_HandSolder
R2, R4, R5, R8: 1k; R_0805_2012Metric_Pad1.15x1.40mm_HandSolder
R3, R10: 100K; R_0805_2012Metric_Pad1.15x1.40mm_HandSolder
R6: 3k; R_0805_2012Metric_Pad1.15x1.40mm_HandSolder
R7: 2k; R_0805_2012Metric_Pad1.15x1.40mm_HandSolder
R9: 510; R_0805_2012Metric_Pad1.15x1.40mm_HandSolder
R11: 390; R_0805_2012Metric_Pad1.15x1.40mm_HandSolder; LCSC C17477
SW1, SW2, SW3: SW_Push; SW_SPST_PTS645
U1: LD1117S33TR_SOT223; SOT-223-3_TabPin2
U2: STM32F091RCTx; LQFP-64_10x10mm_P0.5mm
X1: 32.768kHz(12.5pF); ECX-.327-CDX-1293
X2: 8MHz(20pF); Crystal_SMD_3225-4Pin_3.2x2.5mm

Connections:
+3V0: C5.1, C6.1, C7.1, C8.1, D2.1 (K), FB1.2, J1.21, J2.21, R2.1, R3.1, SW2.1, SW3.1, U2.1 (VBAT), U2.19 (VDD), U2.32 (VDD), U2.48 (VDDIO2), U2.64 (VDD)
+5V: C1.1, C3.1, D1.1 (K), J1.1, J2.1, R1.1, U1.3 (VI)
/3VA: C9.1, FB1.1, U2.13 (VDDA)
/BOOT0: J2.4, R10.1, U2.60 (PF11)
/NRST: C11.1, J1.2, J3.1, R3.2, SW1.2, U2.7 (NRST)
/PA0: J1.20, R4.1, U2.14 (PA0)
/PA1: J1.19, U2.15 (PA1)
/PA2: J1.18, U2.16 (PA2)
/PA3: J1.17, U2.17 (PA3)
/PA4: J1.16, U2.20 (PA4)
/PA5: J1.15, U2.21 (PA5)
/PA6: J1.14, U2.22 (PA6)
/PA7: J1.13, U2.23 (PA7)
/PA8: J1.12, U2.41 (PA8)
/PA9: J1.11, U2.42 (PA9)
/PA10: J1.10, U2.43 (PA10)
/PA11: J1.9, U2.44 (PA11)
/PA12: J1.8, U2.45 (PA12)
/PA13: J1.7, J3.2, U2.46 (PA13)
/PA14: J1.6, J3.6, U2.49 (PA14)
/PA15: J1.5, U2.50 (PA15)
/PB0: J2.22, U2.26 (PB0)
/PB1: J2.23, U2.27 (PB1)
/PB2: J2.24, R5.1, U2.28 (PB2)
/PB3: J2.25, U2.55 (PB3)
/PB4: J2.26, U2.56 (PB4)
/PB5: J2.27, U2.57 (PB5)
/PB6: J2.28, U2.58 (PB6)
/PB7: J2.29, U2.59 (PB7)
/PB8: J1.29, U2.61 (PB8)
/PB9: J1.28, U2.62 (PB9)
/PB10: J1.27, U2.29 (PB10)
/PB11: J1.26, U2.30 (PB11)
/PB12: J1.25, U2.33 (PB12)
/PB13: J1.24, U2.34 (PB13)
/PB14: J1.23, U2.35 (PB14)
/PB15: J1.22, U2.36 (PB15)
/PC0: J2.5, U2.8 (PC0)
/PC1: J2.6, U2.9 (PC1)
/PC2: J2.7, U2.10 (PC2)
/PC3: J2.8, U2.11 (PC3)
/PC4: J2.9, U2.24 (PC4)
/PC5: J2.10, U2.25 (PC5)
/PC6: J2.11, R6.2, U2.37 (PC6)
/PC7: J2.12, R7.2, U2.38 (PC7)
/PC8: J2.13, R8.2, U2.39 (PC8)
/PC9: J2.14, R9.2, U2.40 (PC9)
/PC10: J2.15, U2.51 (PC10)
/PC11: J2.16, U2.52 (PC11)
/PC12: J2.17, U2.53 (PC12)
/PC13: J2.18, U2.2 (PC13)
/PC14: J4.3, U2.3 (PC14)
/PC15: J4.4, U2.4 (PC15)
/PD2: J1.4, U2.54 (PD2)
/PF0: J5.3, U2.5 (PF0)
/PF1: J5.4, U2.6 (PF1)
/U5V: D1.2 (A), J3.9, J3.10
/V3.3_IN: J3.7, J3.8
/XPC14: J2.19, J4.1
/XPC15: J2.20, J4.2
/XPF0: J2.2, J5.1
/XPF1: J2.3, J5.2
GND: C1.2, C2.2, C3.2, C4.2, C5.2, C6.2, C7.2, C8.2, C9.2, C11.2, C12.2, C13.2, C14.2, C15.2, J1.3, J1.30, J2.30, J3.3, J3.4, LD1.1 (K), LD2.1 (K), LD3.1 (K), LD4.1 (K), LD5.1 (K), LD6.1 (K), R10.2, SW1.1, U1.1 (GND), U2.12 (VSSA), U2.18 (VSS), U2.31 (VSS), U2.47 (VSS), U2.63 (VSS)
unnamed: C2.1, C4.1, D2.2 (A), U1.2 (VO)
unnamed: C12.1, J4.5, X1.1
unnamed: C13.1, J4.6, X1.2
unnamed: C14.1, J5.5, X2.1
unnamed: C15.1, R11.2, X2.2
unnamed: J5.6, R11.1
unnamed: LD1.2 (A), R1.2
unnamed: LD2.2 (A), R2.2
unnamed: LD3.2 (A), R9.1
unnamed: LD4.2 (A), R8.1
unnamed: LD5.2 (A), R7.1
unnamed: LD6.2 (A), R6.1
unnamed: R4.2, SW2.2
unnamed: R5.2, SW3.2

Notes on the sheet:
1.8V @ 0.7mA
2V @ 0.18mA
2.8V @ 0.18mA
2.8V @ 0.4mA
600Ohm @ 100MHz .3 Ohm DCR, 500 mA
1.8V @ .4mA
2V @ 0.55mA
(nominal: 4.6 V)
(nominal: 2.95 V)

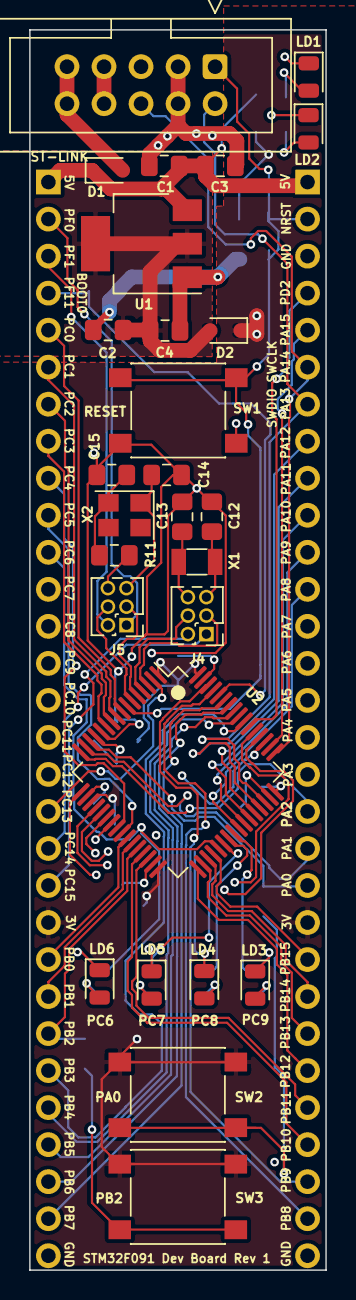
[picture p47: board stm32f091.kicad_pcb from above]

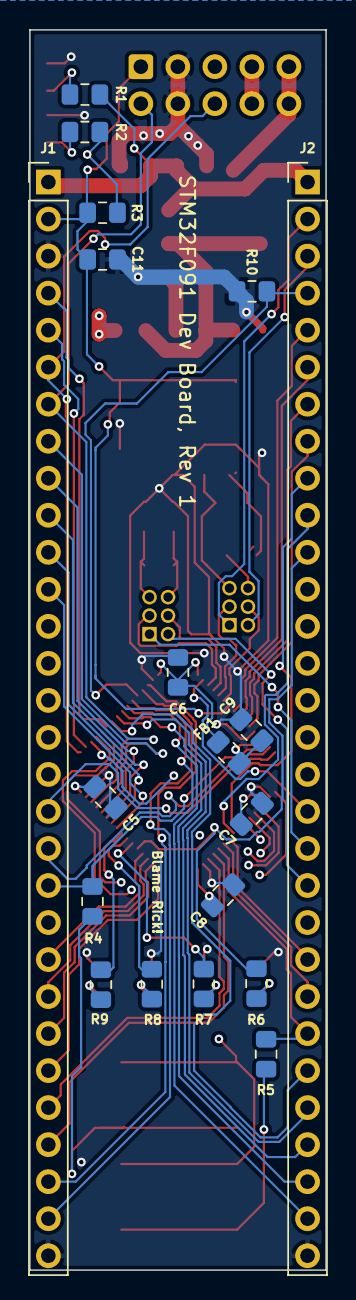
[picture p48: board stm32f091.kicad_pcb from below]

Board: 4 copper layers, 20.3 x 85.1 mm, 46 parts (19 on the bottom side), 77 nets.
