CameronMccutcheon02/ECE477/Software/Main Micro Code/Core/Src/main.c

/* USER CODE BEGIN Header */
/**
  ******************************************************************************
  * @file           : main.c
  * @brief          : Main code for Autonomous Air Hockey Robot
  ******************************************************************************
*/

/* Includes ------------------------------------------------------------------*/
#include "main.h"
#include <stdio.h>
#include <string.h>

SPI_HandleTypeDef hspi1;			//SPI for 7-segment display
TIM_HandleTypeDef htim1;			//tim1 - MOTORS
TIM_HandleTypeDef htim2;			//tim2 - DECELERATION
TIM_HandleTypeDef htim3;			//tim3 - ACCELERATION
TIM_HandleTypeDef htim15;			//tim15 - MULTIPLEXING for 7Segment
UART_HandleTypeDef huart2;			//UART2 for communications
DMA_HandleTypeDef hdma_usart2_rx;	//DMA RX variable for receiving data over UART

//General Initializations
void SystemClock_Config(void);
static void MX_GPIO_Init(void);
//Timers
static void MX_TIM1_Init(void);
static void MX_TIM2_Init(void);
static void MX_TIM3_Init(void);
static void MX_TIM15_Init(void);
//Communications
static void MX_DMA_Init(void);
static void MX_USART2_UART_Init(void);
static void MX_SPI1_Init(void);

/* Variable Declaration */
uint8_t rxdata[4];					//buffer for data sent from PC/camera
int target_ccr_acc = 200;//300; 			//target CCR value for TIM1 when accelerating (top speed)
int target_ccr_acc_ud = 140;
int target_ccr_dec = 450;//600;			//target CCR value for TIM1 when decelerating (lowest speed before stopping)
int starting_ccr = 350; 			//initial CCR value for TIM1 (starting speed)
int down_flag=0;
int up_flag=0;
int left_flag=0;
int righ_flag=0;
int dl_flag=0;
int ur_flag=0;
int dr_flag=0;
int ul_flag=0;
int ir_flag = 0;

//SPI PINS and variables
const int latchPin = ((uint16_t)0x0010U);		//variable for pulling latchPin high and low
#define HOLDING_CYCLES 0
uint8_t segvalue[8] = {0,0,0,0,0,0,0,0};	//array storing the numbers shown on 7-segment display
uint8_t display_select = 0;						//initial display selection (rightmost middle display)
uint8_t hold = 0;								//used for multiplexing larger displays

//Main code
int main(void)
{
	//Initializations
	HAL_Init();					//initialize all peripherals, flash interface, and Systick
	SystemClock_Config();		//configure system clock (8 MHz)

	/* Initialize all configured peripherals */
	MX_GPIO_Init();
	MX_DMA_Init();
	MX_USART2_UART_Init();
	MX_SPI1_Init();

	MX_TIM1_Init();
	MX_TIM2_Init();
	MX_TIM3_Init();
	MX_TIM15_Init();

	/* Start acceleration timer and multiplexing timer */
	HAL_TIM_Base_Start_IT(&htim3);
	HAL_TIM_Base_Start_IT(&htim15);

	/* Initialize rxdata to receive data over UART  */
	HAL_UART_Receive_DMA(&huart2, rxdata, sizeof(rxdata));

	/* Initialize PWM signals */
	HAL_Delay(3000);				//delay 3s to allow for tolerance w motor drivers
	TIM1->CCR1 = 175;
	TIM1->CCR3 = 175;
	TIM1->ARR = 350;
	HAL_TIM_PWM_Stop(&htim1, TIM_CHANNEL_1);
	HAL_TIM_PWM_Stop(&htim1, TIM_CHANNEL_3);

	/* USER CODE BEGIN WHILE */
	while (1)
	{
	  //scan for each direction flag and enter the given functions accordingly
	  if(down_flag){down();}
	  else if(up_flag){up();}
	  else if(left_flag){left();}
	  else if(righ_flag){righ();}
	  else if(dl_flag){dl();}
	  else if(ur_flag){ur();}
	  else if(dr_flag){dr();}
	  else if(ul_flag){ul();}
//	  if(ir_flag){
//		  HAL_NVIC_DisableIRQ(EXTI4_15_IRQn);
//		  HAL_Delay(3000);
//		  HAL_NVIC_EnableIRQ(EXTI4_15_IRQn);
//		  ir_flag = 0;
//	  }
	  }
 }


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
/* USER CODE BEGIN 4 */
void HAL_GPIO_EXTI_Callback(uint16_t GPIO_Pin)
{
	/* Used for displaying each player's score on the 7-segment display */
	UNUSED(GPIO_Pin);
	if(GPIO_Pin == GPIO_PIN_6)	//IR sensor 1
	{
		if(segvalue[6] >= 9){
			segvalue[7] = segvalue[7] + 1;
			segvalue[6] = 0;
		}
		else
		{
		segvalue[6] = segvalue[6] + 1;
		}
	}
	if(GPIO_Pin == GPIO_PIN_7)	//IR sensor 2
	{
		if(segvalue[4] >= 9){
			segvalue[5] = segvalue[5] + 1;
			segvalue[4] = 0;
		}
		else
		{
		segvalue[4] = segvalue[4] + 1;
		}
	}
	ir_flag = 1;

}

void down()
{
	/* Called to move mallet down */
	HAL_TIM_PWM_Stop(&htim1, TIM_CHANNEL_1);
	HAL_TIM_PWM_Stop(&htim1, TIM_CHANNEL_3);
	HAL_GPIO_WritePin(GPIOA, (GPIO_PIN_9), SET);
	HAL_GPIO_WritePin(GPIOA, (GPIO_PIN_11), SET);
	HAL_TIM_PWM_Start(&htim1, TIM_CHANNEL_1);
	HAL_TIM_PWM_Start(&htim1, TIM_CHANNEL_3);
	down_flag=0;
}

void up()
{
	/* Called to move mallet up */
	HAL_TIM_PWM_Stop(&htim1, TIM_CHANNEL_1);
	HAL_TIM_PWM_Stop(&htim1, TIM_CHANNEL_3);
	HAL_GPIO_WritePin(GPIOA, (GPIO_PIN_9), RESET);
	HAL_GPIO_WritePin(GPIOA, (GPIO_PIN_11), RESET);
	HAL_TIM_PWM_Start(&htim1, TIM_CHANNEL_1);
	HAL_TIM_PWM_Start(&htim1, TIM_CHANNEL_3);
	up_flag=0;
}

void left()
{
	/* Called to move mallet left */
	HAL_GPIO_WritePin(GPIOA, (GPIO_PIN_9), SET);
	HAL_GPIO_WritePin(GPIOA, (GPIO_PIN_11), RESET);
	HAL_TIM_PWM_Start(&htim1, TIM_CHANNEL_1);
	HAL_TIM_PWM_Start(&htim1, TIM_CHANNEL_3);
	left_flag=0;
}

void righ()
{
	/* Called to move mallet right */
	HAL_GPIO_WritePin(GPIOA, (GPIO_PIN_9), RESET);
	HAL_GPIO_WritePin(GPIOA, (GPIO_PIN_11), SET);
	HAL_TIM_PWM_Start(&htim1, TIM_CHANNEL_1);
	HAL_TIM_PWM_Start(&htim1, TIM_CHANNEL_3);
	righ_flag=0;
}

void dl()
{
	/* Called to move mallet down and left */
	HAL_TIM_PWM_Stop(&htim1, TIM_CHANNEL_3);
	HAL_GPIO_WritePin(GPIOA, (GPIO_PIN_9), SET);
	HAL_TIM_PWM_Start(&htim1, TIM_CHANNEL_1);
	dl_flag=0;
}

void ur()
{
	/* Called to move mallet up and right */
	HAL_TIM_PWM_Stop(&htim1, TIM_CHANNEL_3);
	HAL_GPIO_WritePin(GPIOA, (GPIO_PIN_9), RESET);
	HAL_TIM_PWM_Start(&htim1, TIM_CHANNEL_1);
	ur_flag=0;
}

void dr()
{
	/* Called to move mallet down and right */
	HAL_TIM_PWM_Stop(&htim1, TIM_CHANNEL_1);
	HAL_GPIO_WritePin(GPIOA, (GPIO_PIN_11), SET);
	HAL_TIM_PWM_Start(&htim1, TIM_CHANNEL_3);
	dr_flag=0;
}

void ul()
{
	/* Called to move mallet up and left */
	HAL_TIM_PWM_Stop(&htim1, TIM_CHANNEL_1);
	HAL_GPIO_WritePin(GPIOA, (GPIO_PIN_11), RESET);
	HAL_TIM_PWM_Start(&htim1, TIM_CHANNEL_3);
	ul_flag=0;
}

void reset_and_accelerate()
{
	/* Called to reset motors to initial speed whenever data is received over UART */
	starting_ccr = 350;
	TIM1->CCR1 = (0.5) * starting_ccr;
	TIM1->CCR3 = (0.5) * starting_ccr;
	TIM1->ARR = starting_ccr;
}

/* USER CODE BEGIN 4 */
void HAL_UART_RxCpltCallback(UART_HandleTypeDef *huart)	//rx transfer completed caldrack
{
	/* Callback function triggered when data is received over UART */

	UNUSED(huart);
	HAL_UART_Transmit(&huart2, rxdata, sizeof(rxdata), 100);
	reset_and_accelerate();
	if(strstr(rxdata, "down")){
		down_flag=1;
		HAL_TIM_Base_Stop_IT(&htim2);
		HAL_TIM_Base_Start_IT(&htim3);
	}
	else if(strstr(rxdata, "up00")){
		up_flag=1;
		HAL_TIM_Base_Stop_IT(&htim2);
		HAL_TIM_Base_Start_IT(&htim3);
	}
	else if(strstr(rxdata, "left")){
		left_flag=1;
		HAL_TIM_Base_Stop_IT(&htim2);
		HAL_TIM_Base_Start_IT(&htim3);
	}
	else if(strstr(rxdata, "righ")){
		righ_flag=1;
		HAL_TIM_Base_Stop_IT(&htim2);
		HAL_TIM_Base_Start_IT(&htim3);
	}
	else if(strstr(rxdata, "dl00")){
		dl_flag=1;
		HAL_TIM_Base_Stop_IT(&htim2);
		HAL_TIM_Base_Start_IT(&htim3);
	}
	else if(strstr(rxdata, "ul00")){
		ul_flag=1;
		HAL_TIM_Base_Stop_IT(&htim2);
		HAL_TIM_Base_Start_IT(&htim3);
	}
	else if(strstr(rxdata, "dr00")){
		dr_flag=1;
		HAL_TIM_Base_Stop_IT(&htim2);
		HAL_TIM_Base_Start_IT(&htim3);
	}
	else if(strstr(rxdata, "ur00")){
		ur_flag=1;
		HAL_TIM_Base_Stop_IT(&htim2);
		HAL_TIM_Base_Start_IT(&htim3);
	}
	else{
		HAL_TIM_Base_Start_IT(&htim2);
		HAL_TIM_Base_Stop_IT(&htim3);
	}
}

uint8_t TranslateDigit(int digit) {
	/* Used in translating decimal digits to bytes to be send over SPI */

    //uint8_t segments[10] = {0xfc, 0x60, 0xda, 0xf2, 0x66, 0xb6, 0xbe, 0xe0, 0xfe, 0xf6};
	uint8_t segments[11] = {0b11111100, 0b01100000, 0b11011010, 0b11110010, 0b01100110, 0b10110110, 0b00111110, 0b11100000, 0b11111110, 0b11100110, 0b00000000};
    if (digit >= 0 && digit <= 10) {
        return segments[digit];
    }
}
// Callback: timer has rolled over
void HAL_TIM_PeriodElapsedCallback(TIM_HandleTypeDef *htim)
{
//	if(GPIO_PIN_6 == 1)	//IR sensor 1
//	{
//		if(segvalue[6] >= 9){
//			segvalue[7] = segvalue[7] + 1;
//			segvalue[6] = 0;
//		}
//		else
//		{
//		segvalue[6] = segvalue[6] + 1;
//		}
//	}
//	else if(GPIO_PIN_7 == 1)	//IR sensor 2
//	{
//		if(segvalue[4] >= 9){
//			segvalue[5] = segvalue[5] + 1;
//			segvalue[4] = 0;
//		}
//		else
//		{
//		segvalue[4] = segvalue[4] + 1;
//		}
//	}
	/* Callback function for all timer interrupts */
	if (htim == &htim2)
	{
		/* Start Deceleration */
	  if (starting_ccr < target_ccr_dec)
	  {
		  starting_ccr = starting_ccr * 1.1;
		  TIM1->CCR1 = (0.5) * starting_ccr;
		  TIM1->CCR3 = (0.5) * starting_ccr;
		  TIM1->ARR = starting_ccr;
	  }
	  if (starting_ccr >= target_ccr_dec)
	  {
		HAL_TIM_PWM_Stop(&htim1, TIM_CHANNEL_1);
		HAL_TIM_PWM_Stop(&htim1, TIM_CHANNEL_3);
	  }
	}
	if (htim == &htim3)
	{
//		if(starting_ccr > target_ccr_acc)
//		{
//			starting_ccr = starting_ccr * .9;
//			TIM1->CCR1 = (0.5) * starting_ccr;
//			TIM1->CCR3 = (0.5) * starting_ccr;
//			TIM1->ARR = starting_ccr;
//		}

		/* Start Acceleration  */
		if((strstr(rxdata, "down") || (strstr(rxdata, "up00")))){
			if(starting_ccr > target_ccr_acc_ud)
			{
				starting_ccr = starting_ccr * .9;
				TIM1->CCR1 = (0.5) * starting_ccr;
				TIM1->CCR3 = (0.5) * starting_ccr;
				TIM1->ARR = starting_ccr;
			}
		}
		else{
			if(starting_ccr > target_ccr_acc)
			{
				starting_ccr = starting_ccr * .9;
				TIM1->CCR1 = (0.5) * starting_ccr;
				TIM1->CCR3 = (0.5) * starting_ccr;
				TIM1->ARR = starting_ccr;
			}
		}
	}

//	if (0 == 0) {
	if(htim == &htim15){
		/* Start Multiplexing  */

		HAL_GPIO_WritePin(GPIOB, latchPin, GPIO_PIN_RESET);	// pull latch pin HIGH
		for (int i = 0; i < 500; i++) {

				}
		uint8_t segment;
		segment = TranslateDigit(segvalue[display_select]);
		segment = ~segment;

		uint8_t tx_data[3];

		tx_data[0] = 0x00;
		tx_data[1] = segment;
		tx_data[2] = (0x01 << display_select);

//		tx_data[1] = 1;

		HAL_SPI_Transmit(&hspi1, tx_data, 3, 100);
			// pull latch pin HIGH

//		if ((display_select > 3) && (hold < HOLDING_CYCLES)) {
//			hold++;
//		}
//		else {
//			display_select++;
//			if (display_select == 8) {
//			  display_select = 0;
//			}
//			hold = 0;
//		}

		for (int i = 0; i < 500; i++) {

		}

		display_select++;
			if (display_select == 8) {
			  display_select = 0;
			}
		HAL_GPIO_WritePin(GPIOB, latchPin, GPIO_PIN_SET);
	}

}

/**
  * @brief  This function is executed in case of error occurrence.
  * @retval None
  */
void Error_Handler(void)
{
  /* USER CODE BEGIN Error_Handler_Debug */
  /* User can add his own implementation to report the HAL error return state */
  __disable_irq();
  while (1)
  {
  }
  /* USER CODE END Error_Handler_Debug */
}

#ifdef  USE_FULL_ASSERT
/**
  * @brief  Reports the name of the source file and the source line number
  *         where the assert_param error has occurred.
  * @param  file: pointer to the source file name
  * @param  line: assert_param error line source number
  * @retval None
  */
void assert_failed(uint8_t *file, uint32_t line)
{
  /* USER CODE BEGIN 6 */
  /* User can add his own implementation to report the file name and line number,
     ex: printf("Wrong parameters value: file %s on line %d\r\n", file, line) */
  /* USER CODE END 6 */
}
#endif /* USE_FULL_ASSERT */
