CameronMccutcheon02/ECE477/Personals/Abby/comms/test.c

#include<stdio.h>
#include<string.h>


char *str = "Tom Manager 28";
char name[10], designation[10];
int age, ret;

ret = sscanf(str, "%s %s %d", name, designation, &age);

printf("Name: %s\n", name);
printf("Designation: %s\n", designation);
printf("Age: %d\n", age);

// signal to operating system program ran fine
