CameronMccutcheon02/ECE477/(commit log)

2023-09-07 Adds frame by frame prediction
2023-09-07 Added Purchase request excel sheet
    [Senior Design Purchase Request.xlsx]
2023-09-07 Fixed thing
    [Senior Design Purchase Request.xlsx]
2023-09-08 Adds green puck request
    [Senior Design Purchase Request.xlsx]
2023-09-08 Updated Procurement Form
    [Senior Design Purchase Request.xlsx]
2023-09-10 initial commit for PCB design
    [MainMicro.kicad_pcb, MainMicro.kicad_sch]
2023-09-10 Fix small Mistake in RCC oscillator setup
    [ECE477 Micro.ioc, main.c]
2023-09-12 Started USB 2.0 Support Interface
    [MainMicro.kicad_sch]
2023-09-12 Small cleanup to sch
    [MainMicro.kicad_sch]
2023-09-14 Added purchase forms
    [Senior Design Purchase Request (Adafruit) - Copy.xlsx, Senior Design Purchase Request (Adafruit).xlsx, Senior Design Purchase Request (Amazon).xlsx]
2023-09-14 updated purchase form
    [Senior Design Purchase Request (Mouser).xlsx]
2023-09-16 More PCB stuff
    [MainMicro.kicad_sch]
2023-09-19 Puck Funnel Design
    [Puck Funnel.stl]
2023-09-19 PCB Power Supply + General Changes
    [MainMicro.kicad_sch]
2023-09-29 PCB workings
    [ECX-.327-CDX-1293.step, HTSW-130-22-T-S.FCStd, MainMicro.kicad_sch, stm32f091.kicad_pcb, stm32f091.sch]
2023-10-02 Sensor Schematic
    [Sensor.kicad_pcb, Sensor.kicad_sch]
2023-10-04 PCB footprint assignment
    [MainMicro.kicad_sch]
2023-10-04 PCB layout start
    [MainMicro.kicad_pcb, MainMicro.kicad_sch]
2023-10-08 Big PCB changes
    [MainMicro.kicad_pcb, MainMicro.kicad_sch]
2023-10-09 PCB passing DRC
    [MainMicro.kicad_pcb, MainMicro.kicad_sch]
2023-10-10 Shift Register Schematic and Motor Driver code.
    [Motor Debug.cfg, Scoreboard.kicad_pcb, Scoreboard.kicad_sch]
2023-10-10 Fixed Joe concerns
    [MainMicro.kicad_pcb, MainMicro.kicad_sch]
2023-10-11 Small change
    [MainMicro.kicad_sch]
2023-10-11 Minor schematic changes and PCB dimensions
    [MainMicro.kicad_pcb, MainMicro.kicad_sch]
2023-10-12 Added Logic translation for SPI
    [MainMicro.kicad_pcb, MainMicro.kicad_sch]
2023-10-12 Updated PCBs
    [MainMicro.kicad_pcb, Scoreboard.kicad_pcb, Scoreboard.kicad_sch]
2023-10-17 Updating changes
    [Sensor.kicad_pcb, Sensor.kicad_sch]
2023-10-17 notes and procurement
    [Senior Design Purchase Request (Amazon)(2).xlsx, cam v1 v0.stl, cam v1 v2.stl, puck v1.stl]
2023-10-18 Basic Pin setup for code
2023-10-20 Please don't break
    [MainMicro.kicad_pcb, MainMicro.kicad_sch, Senior Design Purchase Request (Amazon)(2).xlsx, cam v1 v0.stl, cam v1 v2.stl, puck v1.stl]
2023-10-20 Commit for PCB final
    [MainMicro.kicad_pcb, MainMicro.kicad_sch]
2023-10-20 Generated Main Micro Gerber Files
    [MainMicro-B_Cu.gbl, MainMicro-B_Mask.gbs, MainMicro-B_Paste.gbp, MainMicro-B_Silkscreen.gbo, MainMicro-Edge_Cuts.gm1, MainMicro-F_Cu.gtl, MainMicro-F_Mask.gts, MainMicro-F_Paste.gtp]
2023-10-20 Gerber FIle
2023-10-20 adds automatic color calibration
2023-10-20 Post joe
    [MainMicro-B_Cu.gbl, MainMicro-B_Mask.gbs, MainMicro-B_Paste.gbp, MainMicro-B_Silkscreen.gbo, MainMicro-Edge_Cuts.gm1, MainMicro-F_Cu.gtl, MainMicro-F_Mask.gts, MainMicro-F_Paste.gtp]
2023-10-21 Bunch of random backups that kicad did
2023-10-24 Protoboard Schematic with MAX6971 LED driver
    [Protoboard.kicad_pcb, Protoboard.kicad_sch]
2023-11-03 Protoboard layout.
    [Protoboard.kicad_pcb, Protoboard.kicad_sch, Scoreboard.kicad_pcb]
2023-11-05 pcb assembly notes and cad
    [24v mount v1.f3d]
2023-11-06 updated pcb assembly notes
2023-11-06 Finished Protoboard
    [Protoboard.kicad_pcb, Protoboard.kicad_sch]
2023-11-06 Fixed Silkscreen
    [Protoboard.kicad_pcb, Protoboard.kicad_sch]
2023-11-15 adds new calibration pics
2023-11-18 adds waiting functionality and software limit switches
2023-11-19 added notes and software stuff
    [24v mount v2.stl]
2023-11-20 motor keys code
2023-11-20 updates track
